killua365/fpgachina2026-sr-lut/skill/evidence/collaboration_record.md

# 本轮模型协作与纠错记录

日期：2026-10-20。模型角色：当前Codex编码助手；未调用子智能体或另一个模型。本文只记录本轮Skill任务，历史部分标为依据项目文件的复盘，不假冒原始对话导出。

## 用户需求的真实节选

> 参照赛题的要求，根据项目的具体情况，为我完成skill部分的内容，写清它在本队题目之外还能用在哪类场景

用户选择“文档＋脚本＋示例”，并要求确认这是PYNQ Skill。助手随后明确：

> PYNQ 是板端硬件运行的必需依赖；离线校验工具和教学示例可以在未安装 PYNQ 的普通电脑上独立运行。

用户最终要求：

> 按照方案执行，（严格参照赛题要求）

## 本轮执行记录

1. 读取3.3.2和3.3.5.2原条款，核对当前驱动和硬件验证脚本。发现原帧会话仍依赖SR专用寄存器，不宜直接作为通用模板。
2. 按P1/P2的合同及独立参考步骤设计两个场景：uint8阈值分割、int16采样饱和增益。黄金用标量整数运算，被测模拟用独立NumPy实现。
3. 编写实际PYNQ后端，通过显式Overlay加载、allocate与DMA transfer接入；算法控制交给hooks。离线入口不导入PYNQ。
4. 第一版模拟缓冲区使用 `obj.device` 保存设备侧数组。实际NumPy 2.x运行报错：

```text
AttributeError: attribute 'device' of 'numpy.ndarray' objects is not writable
```

5. 当时记录为23项、7个错误、0个断言失败；错误集中在模拟缓冲区构造。见 `initial_regression.json`，包含实际错误输出、环境与源码哈希。
6. 助手依据实际错误把自定义存储属性改为 `device_storage`，没有更改阈值、增益或判定标准。随后23项通过，两个外部场景运行及损坏数据检出均通过。后续新增检查和最终数量以 `regression.json`、`qualification.json` 为准。
7. 按P3/P4的方法复核r11 ARM记录及r5固定窗口记录，分别标记短测与历史持续验收；没有重启当前板端演示或伪造新板测试。

本文件是依据实际本轮操作编写的可追溯过程记录；提示词目录为提炼后的可复用版本，并不是声称上述模板文本曾在历史r5/r11阶段逐字输入。

## 结果与模型能力边界

工具结果证明具体脚本在记录环境中的行为。没有多模型、多次随机生成的成功率试验，不能宣称这些提示词对任意模型保证正确。使用者应执行相同的正例、反例和目标板验证。
