killua365/fpgachina2026-sr-lut/report/collaboration/index.md

# 大模型协作记录

工程开发使用大模型辅助分析、编码与验证。保留的记录覆盖通用 PYNQ Skill 的需求、方案、实际失败与修正，以及从 SR-LUT 项目提炼方法的过程。

| 资料 | 内容 |
|---|---|
| [真实需求与纠错记录](../../skill/evidence/collaboration_record.md) | 用户提示词节选、助手回答、NumPy 模拟缓冲区错误及修复 |
| [方法提炼过程](../../skill/evidence/derivation.md) | 从 DMA、缓存、像素校验及性能统计问题形成可复用流程 |
| [来源索引](../../skill/evidence/source_index.json) | 原始证据位置、内容哈希和 Skill 内对应文件 |
| [提示词工作流](../../skill/prompts/usage.md) | 经整理的可复用模板 |
| [机器可读索引](records.json) | 上述主要记录的 SHA-256 |

这些资料是现存任务记录和基于原始证据的整理，覆盖范围在各文件中说明。提示词模板不是历史逐字聊天记录；未据此补写不存在的对话或测试结果。
