killua365/fpgachina2026-sr-lut/skill/evidence/image_threshold/report.md

# PYNQ Skill 检查结果

- 通过：True
- 本轮硬件访问：否；不构成新板卡验收。

```json
{
  "schema": "pynq_skill_validation_v1",
  "date": "2026-10-20T19:09:30.595845+08:00",
  "hardware_access": false,
  "new_board_validation": false,
  "python": "3.12.14",
  "numpy": "2.2.6",
  "platform": "Windows-11-10.0.26200-SP0",
  "config_sha256": "9d28c4bf34c6cb34b576d8898f1ae898ba6bf69d05d6dc3a222fce5d29d514ce",
  "checks": {
    "golden": {
      "passed": true,
      "elements": 1536,
      "mismatches": 0,
      "maximum_absolute_error": 0.0,
      "atol": 0.0,
      "rtol": 0.0
    },
    "corruption_detected": {
      "passed": true
    }
  },
  "example": "image_threshold",
  "execution": "offline_simulated_dma",
  "measurement": {
    "host_total_seconds": 0.0,
    "hardware_access": false
  },
  "lifecycle_events": [
    "sync_to_device",
    "sync_to_device",
    "configure",
    "receive",
    "start",
    "send",
    "complete",
    "sync_from_device",
    "halt",
    "free",
    "free"
  ],
  "passed": true,
  "not_requested": [
    "files",
    "hwh",
    "throughput",
    "timing",
    "utilization"
  ]
}
```
