killua365/fpgachina2026-sr-lut/data/golden/fixed_x4_set5/bird_golden_1280x720.png

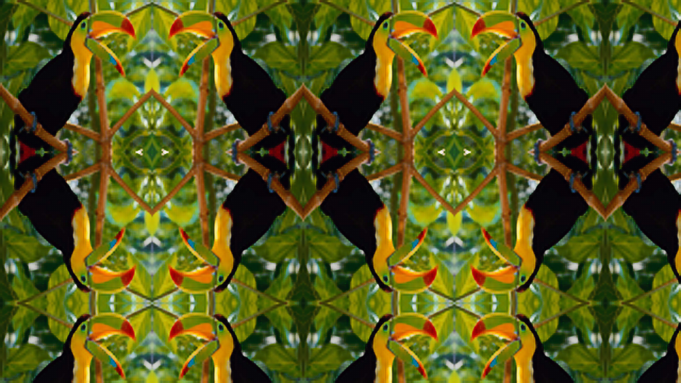
data/golden/fixed_x4_set5/bird_golden_1280x720.png
