killua365/fpgachina2026-sr-lut/data/golden/fixed_x4_set5/bird_input_320x180.png

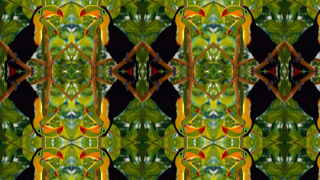
data/golden/fixed_x4_set5/bird_input_320x180.png
