killua365/fpgachina2026-sr-lut/data/golden/reference_baselines/x4_5bit/butterfly.png

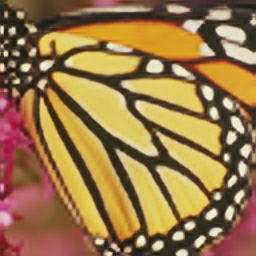
data/golden/reference_baselines/x4_5bit/butterfly.png
