killua365/fpgachina2026-sr-lut/data/golden/reference_baselines/x4_5bit/head.png

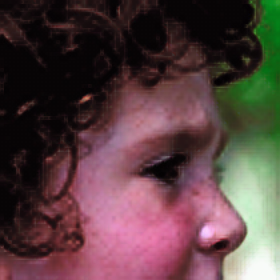
data/golden/reference_baselines/x4_5bit/head.png
