killua365/fpgachina2026-sr-lut/data/golden/reference_baselines/x4_5bit_boundaries/odd_gradient.png

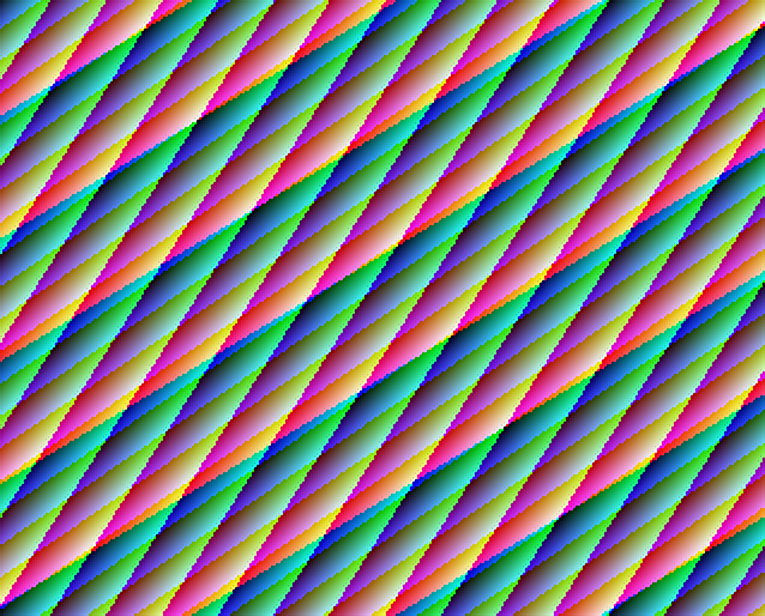
data/golden/reference_baselines/x4_5bit_boundaries/odd_gradient.png
