killua365/fpgachina2026-sr-lut/data/golden/smoke/golden_x2.png

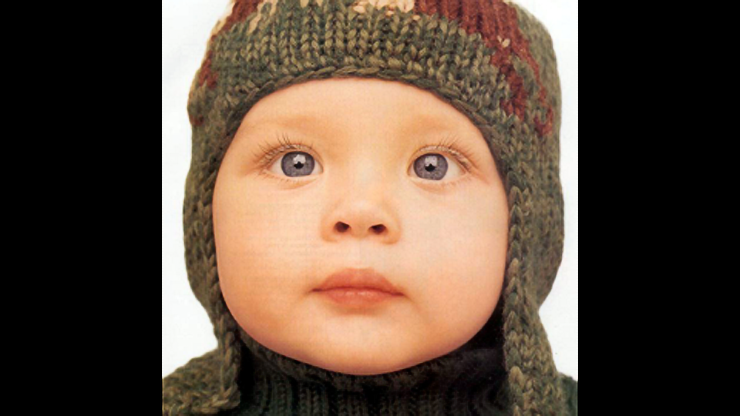
data/golden/smoke/golden_x2.png
