killua365/fpgachina2026-sr-lut/data/images/bird.png

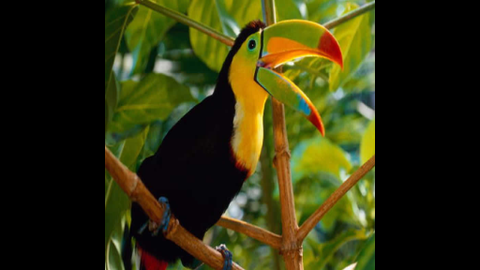
data/images/bird.png
