killua365/fpgachina2026-sr-lut/data/images/butterfly.png

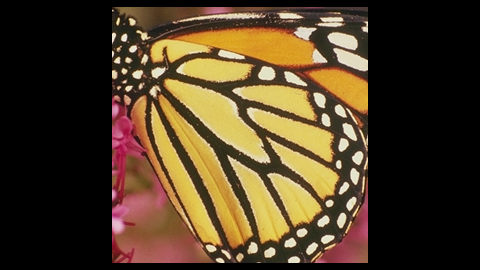
data/images/butterfly.png
