killua365/fpgachina2026-sr-lut/data/images/head.png

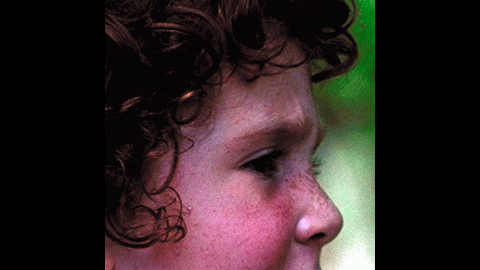
data/images/head.png
