killua365/fpgachina2026-sr-lut/data/images/woman.png

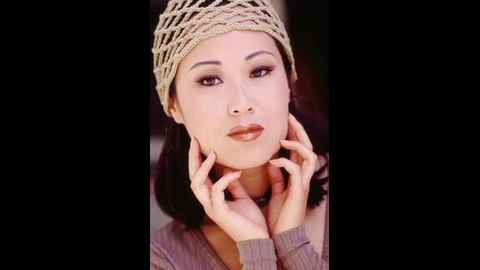
data/images/woman.png
