killua365/fpgachina2026-sr-lut/report/performance/camera_20fps_2026-10-18.md

# 摄像头完整新显示帧率测量

测量日期：2026-10-18。软件版本：`n5_business_20261018_r5`。会话：`228de59787e74140be1f62a6d9060c9b`。

| 布局 | Nexys 硬件计时窗口 | 完整新显示帧 | 实际帧率 |
|---|---:|---:|---:|
| SR 全屏 | 300 秒 | 6527 | 21.7567 fps |
| 原图/SR 分屏 | 300 秒 | 6727 | 22.4233 fps |

帧率由 Nexys 完整扫描事件独立重算，排除重复显示；不使用摄像头采集率、PYNQ 提交率或显示器刷新率代替。该结果属于历史 DP 配置，不能直接作为当前 VGA 配置的成绩。

## 条件与实现

摄像头为 640×480 MJPEG，保持面积缩放与宽高比；SR 输入 480×270，x4 输出 1920×1080，HDMI 1080p30，DP 1080p60。LUT、BIT/HWH 和黄金参考数据未因优化而改变。

优化将完整像素校验与复制合并，使用非缓存显示缓冲区，减少重复缓存刷新；全屏复用不透明工具栏，只更新可见图像区域与发生变化的界面元素。鼠标、提示文字、布局或图像代次变化时重新绘制。

x2/x4 黄金输出、30 帧摄像头 SR 结果和 30 帧完整 RGBX 显示画面通过核对，覆盖全屏、分屏和三个轮换缓冲区。SR 输出 X 字节检查包含被工具栏遮住的像素。

## 证据复算

在工程根目录运行：

```powershell
.\tools\python.cmd host tools/recompute_camera.py --out D:\sr_lut_r5_recomputed
```

输出目录须为新目录。工具校验并读取[原始证据包](camera_r5_evidence.zip)，使用包内当时的复算代码，不依赖旧工作目录或当前板卡。普通运行入口与操作见[操作手册](../../docs/user_guide.md)。

相关来源：[r6 来源合同](r6_source_contract.json)、[历史软件验证](../validation/historical_validation.zip)。r6 普通演示包保留 r5 的 124 个载荷文件，仅关闭自动测速并记录来源。

ARM 63 项测试全部通过；主机 155 项中 5 项仅适用于 ARM。标准输入启动曾造成四项多进程测试失败，改用模块入口后对应 10 项通过；启动计时测试曾超阈值约 0.16 秒，完整复测 125 项通过。原始失败与复测记录一并保留。

此结果覆盖表中两项性能，不证明全部模式、插拔可靠性或无主机启动。会话结束记录确认源程序停止、服务与 Nexys 配置恢复；遥测记录与显示器实屏观察分别保存。
