killua365/fpgachina2026-sr-lut/skill/evidence/validation_summary.md

# 本轮验证结果

日期：2026-10-20。所有本轮检查均未访问开发板，未停止或重启当前演示。

| 环境 | 回归 | 独立目录 | 独立示例 | 原报告检查 |
|---|---|---|---|---|
| Python 3.12.14 / NumPy 2.2.6 | 28项通过 | 主项目目录 | 两例通过 | 通过 |
| Python 3.12.14 / NumPy 2.5.4 | 28项通过 | 新venv＋临时独立副本 | 两例通过 | 通过 |
| Python 3.12.14 / NumPy 1.26.4 | 28项通过 | 临时独立副本 | 两例通过 | 通过 |

- 新venv按requirements.txt实际安装依赖；不是只使用原项目已安装的库。
- 图像例子1536个元素，传感器例子36个元素，整数逐元素一致；故意破坏结果均被检出。
- 原x4工程报告：setup WNS 0.144 ns，hold 0.014 ns，pulse 0.538 ns；LUT 19220、FF 18035、RAMB36 111、RAMB18 4、DSP 2。这是历史原报告重读，不是本轮重新综合。
- 第一次23项测试出现7个错误，原因是NumPy 2.x已有device属性；修正并增加边界检查后最终每环境28项通过。失败记录保留。
- 新模板未上板；Python 3.10仅检查语法，未在3.10解释器运行。PYNQ 3.1.1为原项目环境，不冒充新模板实板验证。

原始机器记录见qualification.json及各环境子目录。
