killua365/fpgachina2026-sr-lut/skill/templates/experiment_report.md

# 可复用实验报告模板

- 题目/算法/日期：
- 板卡与器件、PYNQ/Python/NumPy/Vivado版本：
- 源码版本、BIT/HWH与配置的SHA-256：
- 实验层级：离线参考 / 模拟设备 / 真板；是否访问硬件：
- 输入输出规格、同一对比条件：
- 黄金方法、误差口径、边界及故意损坏检出：
- 性能计时起止点、窗口、有效批次数、重复排除、P50/P95/最大延迟：
- 实现后的setup/hold/pulse时序与约束覆盖边界：
- LUT/FF/RAMB36/RAMB18/DSP；预算和实际用途：
- 原始证据路径：
- 失败观察、候选原因、修复与复核：
- 可复用到哪些外部题目、需要修改哪些参数：
- 未验证范围与失效条件：

不能将离线运行或瞬时峰值填入“真板持续性能”；跳过的检查明确写“未执行”。
