killua365/fpgachina2026-sr-lut/report/validation/reorganization_20261020/tests.txt

test_broken_or_nonascii_property_rejected (test_device_status.DeviceStatusTests.test_broken_or_nonascii_property_rejected) ... ok
test_locale_paths_and_line_endings (test_device_status.DeviceStatusTests.test_locale_paths_and_line_endings) ... ok
test_missing_duplicate_and_wrong_identity_rejected (test_device_status.DeviceStatusTests.test_missing_duplicate_and_wrong_identity_rejected) ... ok
test_fragmented_binary_and_chunk_boundaries_are_exact (test_ftdi_capture.CaptureTests.test_fragmented_binary_and_chunk_boundaries_are_exact) ... ok
test_line_error_and_clear_times_preserved_with_all_received_bytes (test_ftdi_capture.CaptureTests.test_line_error_and_clear_times_preserved_with_all_received_bytes) ... ok
test_restoration_failure_and_independent_deadline_fail (test_ftdi_capture.CaptureTests.test_restoration_failure_and_independent_deadline_fail) ... ok
test_new_errors_missing_tail_and_regression_are_rejected (test_ftdi_status.StatusTests.test_new_errors_missing_tail_and_regression_are_rejected) ... ok
test_preexisting_error_must_clear_before_candidate (test_ftdi_status.StatusTests.test_preexisting_error_must_clear_before_candidate) ... ok
test_business_only_limits_fit_independent_hold (test_business_session.SessionTests.test_business_only_limits_fit_independent_hold) ... ok
test_close_requires_dma_worker_and_live_original_service (test_business_session.SessionTests.test_close_requires_dma_worker_and_live_original_service) ... ok
test_complete_raw_stream_and_source_join (test_business_session.SessionTests.test_complete_raw_stream_and_source_join) ... ok
test_current_binding_required_before_final_report (test_business_session.SessionTests.test_current_binding_required_before_final_report) ... ok
test_finalizing_needs_live_binding_and_closed_hardware (test_business_session.SessionTests.test_finalizing_needs_live_binding_and_closed_hardware) ... ok
test_fresh_baseline_is_run_bound (test_business_session.SessionTests.test_fresh_baseline_is_run_bound) ... ok
test_journal_loss_mutation_and_source_replay_fail (test_business_session.SessionTests.test_journal_loss_mutation_and_source_replay_fail) ... ok
test_launch_rejects_old_package_duration_and_foreign_directory (test_business_session.SessionTests.test_launch_rejects_old_package_duration_and_foreign_directory) ... ok
test_probe_uses_closed_worker_report_while_parent_restores (test_business_session.SessionTests.test_probe_uses_closed_worker_report_while_parent_restores) ... ok
test_recent_resynchronization_still_rejects_new_damage_and_sequence_gaps (test_business_session.SessionTests.test_recent_resynchronization_still_rejects_new_damage_and_sequence_gaps) ... ok
test_recent_srb5_rejects_wrong_identity_crc_and_gaps (test_business_session.SessionTests.test_recent_srb5_rejects_wrong_identity_crc_and_gaps) ... ok
test_recent_status_recovers_alignment_without_accepting_corrupt_session (test_business_session.SessionTests.test_recent_status_recovers_alignment_without_accepting_corrupt_session) ... ok
test_source_start_requires_current_live_nexys_session (test_business_session.SessionTests.test_source_start_requires_current_live_nexys_session) ... ok
test_close_keeps_candidate_until_ordered_restore (test_business_session_loader.LoaderTests.test_close_keeps_candidate_until_ordered_restore) ... ok
test_failed_recovery_stays_unknown (test_business_session_loader.LoaderTests.test_failed_recovery_stays_unknown) ... ok
test_operator_loader_keeps_ordering_lease_and_independent_cap (test_business_session_loader.LoaderTests.test_operator_loader_keeps_ordering_lease_and_independent_cap) ... ok
test_preload_failures_never_program (test_business_session_loader.LoaderTests.test_preload_failures_never_program) ... ok
test_watchdogs_and_bad_commands_restore_but_fail (test_business_session_loader.LoaderTests.test_watchdogs_and_bad_commands_restore_but_fail) ... ok
test_boundary_loss_and_hung_loader_are_bounded (test_business_session_supervisor.ControllerTests.test_boundary_loss_and_hung_loader_are_bounded) ... ok
test_closed_worker_waits_for_parent_restore_without_false_failure (test_business_session_supervisor.ControllerTests.test_closed_worker_waits_for_parent_restore_without_false_failure) ... ok
test_finalizing_without_parent_completion_still_times_out (test_business_session_supervisor.ControllerTests.test_finalizing_without_parent_completion_still_times_out) ... ok
test_manual_session_runs_beyond_old_caps_then_closes_before_stop_and_restore (test_business_session_supervisor.ControllerTests.test_manual_session_runs_beyond_old_caps_then_closes_before_stop_and_restore) ... ok
test_manual_source_safety_failure_restores_without_passing (test_business_session_supervisor.ControllerTests.test_manual_source_safety_failure_restores_without_passing) ... ok
test_natural_source_completion_closes_then_recovers_without_prompt (test_business_session_supervisor.ControllerTests.test_natural_source_completion_closes_then_recovers_without_prompt) ... ok
test_operator_finish_preserves_order_and_does_not_send_sudo (test_business_session_supervisor.ControllerTests.test_operator_finish_preserves_order_and_does_not_send_sudo) ... ok
test_raw_factory_tail_is_not_parsed_as_candidate (test_business_session_supervisor.ControllerTests.test_raw_factory_tail_is_not_parsed_as_candidate) ... ok
test_transport_and_cancel_faults_never_pass (test_business_session_supervisor.ControllerTests.test_transport_and_cancel_faults_never_pass) ... ok
test_worker_deadline_and_recovery_failure_remain_failures (test_business_session_supervisor.ControllerTests.test_worker_deadline_and_recovery_failure_remain_failures) ... ok
test_launch_rejects_foreign_path_and_unbounded_profiles_before_hardware (test_hdmi_session_trace.TraceTests.test_launch_rejects_foreign_path_and_unbounded_profiles_before_hardware) ... ok
test_repaint_mode_generation_and_regression (test_hdmi_session_trace.TraceTests.test_repaint_mode_generation_and_regression) ... ok
test_failed_submit_and_failed_trace_cannot_fake_success (test_hdmi_session_trace.ObserverTests.test_failed_submit_and_failed_trace_cannot_fake_success) ... ok
test_observer_follows_submission_and_rejects_stale_pair (test_hdmi_session_trace.ObserverTests.test_observer_follows_submission_and_rejects_stale_pair) ... ok
test_halt_failure_prevents_overlay_replacement (test_hdmi_engine.EngineTests.test_halt_failure_prevents_overlay_replacement) ... ok
test_mode_change_rejects_old_pair_and_geometry_change_closes_session (test_hdmi_engine.EngineTests.test_mode_change_rejects_old_pair_and_geometry_change_closes_session) ... ok
test_modes_reuse_same_scale_and_camera_stays_x4 (test_hdmi_engine.EngineTests.test_modes_reuse_same_scale_and_camera_stays_x4) ... ok
test_roi_uses_original_pixels_and_exact_halo_crop (test_hdmi_engine.EngineTests.test_roi_uses_original_pixels_and_exact_halo_crop) ... ok
test_camera_fixed_scale_and_idle_stop_preserve_display (test_hdmi_runtime.RuntimeTests.test_camera_fixed_scale_and_idle_stop_preserve_display) ... ok
test_camera_recovery_invalidates_old_frame_generation (test_hdmi_runtime.RuntimeTests.test_camera_recovery_invalidates_old_frame_generation) ... ok
test_idle_repaints_surface_and_cannot_count_as_processing (test_hdmi_runtime.RuntimeTests.test_idle_repaints_surface_and_cannot_count_as_processing) ... ok
test_image_repaint_does_not_reprocess_or_count_a_new_source_frame (test_hdmi_runtime.RuntimeTests.test_image_repaint_does_not_reprocess_or_count_a_new_source_frame) ... ok
test_roi_change_rejects_previous_generation_and_uses_original_pixels (test_hdmi_runtime.RuntimeTests.test_roi_change_rejects_previous_generation_and_uses_original_pixels) ... ok
test_status_separates_processing_and_new_frame_rates (test_hdmi_runtime.RuntimeTests.test_status_separates_processing_and_new_frame_rates) ... ok
test_video_seek_and_exact_step_bind_matching_frame_pairs (test_hdmi_runtime.RuntimeTests.test_video_seek_and_exact_step_bind_matching_frame_pairs) ... ok
test_inventory_and_all_python_modules_are_bound (test_business_package_binding.PackageBindingTests.test_inventory_and_all_python_modules_are_bound) ... ok
test_previous_launches_cannot_start_current_session (test_business_package_binding.PackageBindingTests.test_previous_launches_cannot_start_current_session) ... ok
test_inventory_and_verification_stream_large_files_and_reject_changes (test_business_evidence_files.EvidenceFilesTests.test_inventory_and_verification_stream_large_files_and_reject_changes) ... ok
test_transfer_budget_remains_bounded_for_retained_video (test_business_evidence_files.EvidenceFilesTests.test_transfer_budget_remains_bounded_for_retained_video) ... ok
test_foreign_dropin_is_preserved (test_bootpy_once.BootOnceTests.test_foreign_dropin_is_preserved) ... ok
test_install_is_idempotent_and_rollback_removes_only_own_file (test_bootpy_once.BootOnceTests.test_install_is_idempotent_and_rollback_removes_only_own_file) ... ok
test_installer_does_not_start_services_or_reboot (test_bootpy_once.BootOnceTests.test_installer_does_not_start_services_or_reboot) ... ok
test_installer_reverts_file_when_reload_fails (test_bootpy_once.BootOnceTests.test_installer_reverts_file_when_reload_fails) ... ok
test_old_busy_failed_and_incomplete_states_are_rejected (test_bootpy_once.BootOnceTests.test_old_busy_failed_and_incomplete_states_are_rejected) ... ok
test_recovery_never_starts_service_with_uncompleted_boot (test_bootpy_once.BootOnceTests.test_recovery_never_starts_service_with_uncompleted_boot) ... ok
test_successful_exited_initialization_is_not_a_live_owner (test_bootpy_once.BootOnceTests.test_successful_exited_initialization_is_not_a_live_owner) ... ok
test_unexpected_boot_rerun_is_not_success (test_bootpy_once.BootOnceTests.test_unexpected_boot_rerun_is_not_success) ... ok
test_active_candidate_prevents_start (test_business_recovery_status.RecoveryStatusTests.test_active_candidate_prevents_start) ... ok
test_start_timeout_remains_failure (test_business_recovery_status.RecoveryStatusTests.test_start_timeout_remains_failure) ... ok
test_success_records_identity_before_completion (test_business_recovery_status.RecoveryStatusTests.test_success_records_identity_before_completion) ... ok
test_wrong_identity_remains_failure (test_business_recovery_status.RecoveryStatusTests.test_wrong_identity_remains_failure) ... ok
test_persistent_adapter_still_rejects_stale_challenge (test_business_query.PersistentQueryTests.test_persistent_adapter_still_rejects_stale_challenge) ... ok
test_persistent_timeout_does_not_return_a_previous_response (test_business_query.PersistentQueryTests.test_persistent_timeout_does_not_return_a_previous_response) ... ok
test_read_only_server_reuses_process_with_fresh_replies (test_business_query.PersistentQueryTests.test_read_only_server_reuses_process_with_fresh_replies) ... ok
test_controller_failure_closure_or_finalizing_blocks_interaction (test_business_query.ProgressTests.test_controller_failure_closure_or_finalizing_blocks_interaction) ... ok
test_banner_after_five_seconds_reaches_key_exchange (test_business_query.QueryDeadlineTests.test_banner_after_five_seconds_reaches_key_exchange) ... ok
test_silent_peer_still_expires_within_total_budget (test_business_query.QueryDeadlineTests.test_silent_peer_still_expires_within_total_budget) ... ok
test_success_retains_binding_and_timing (test_business_query.QueryTests.test_success_retains_binding_and_timing) ... ok
test_successful_ssh_with_stale_response_is_still_rejected (test_business_query.QueryTests.test_successful_ssh_with_stale_response_is_still_rejected) ... ok
test_timeout_keeps_partial_stages_without_retry_or_binding (test_business_query.QueryTests.test_timeout_keeps_partial_stages_without_retry_or_binding) ... ok
test_transport_failure_preserves_useful_error_without_command (test_business_query.QueryTests.test_transport_failure_preserves_useful_error_without_command) ... ok
test_completed_file_is_preserved_and_final_success_replaces_stale_sample (test_business_final_media.FinalMediaTests.test_completed_file_is_preserved_and_final_success_replaces_stale_sample) ... ok
test_failed_hardware_close_does_not_claim_finalization (test_business_final_media.FinalMediaTests.test_failed_hardware_close_does_not_claim_finalization) ... ok
test_shutdown_during_probe_records_cancel_and_removes_partial (test_business_final_media.FinalMediaTests.test_shutdown_during_probe_records_cancel_and_removes_partial) ... ok
test_cli_propagates_manual_mode_and_rejects_short_cap (test_business_operator.OperatorTests.test_cli_propagates_manual_mode_and_rejects_short_cap) ... ok
test_default_launch_is_demo_but_explicit_seconds_retains_timed (test_business_operator.OperatorTests.test_default_launch_is_demo_but_explicit_seconds_retains_timed) ... ok
test_mode_bound_to_launch_process_worker_and_supervisor (test_business_operator.OperatorTests.test_mode_bound_to_launch_process_worker_and_supervisor) ... ok
test_operator_controller_outlives_old_window_and_preserves_stop_order (test_business_operator.OperatorTests.test_operator_controller_outlives_old_window_and_preserves_stop_order) ... ok
test_operator_faults_and_safety_caps_remain_enforced (test_business_operator.OperatorTests.test_operator_faults_and_safety_caps_remain_enforced) ... ok
test_operator_outlives_five_minutes_and_ends_on_operator (test_business_operator.OperatorTests.test_operator_outlives_five_minutes_and_ends_on_operator) ... ok
test_safety_cap_recovers_as_failure_not_success (test_business_operator.OperatorTests.test_safety_cap_recovers_as_failure_not_success) ... ok
test_camera_cached_overlay_matches_drawing_and_preserves_background (test_hdmi_workspace.WorkspaceTests.test_camera_cached_overlay_matches_drawing_and_preserves_background) ... ok
test_camera_content_band_only_excludes_fully_opaque_rows (test_hdmi_workspace.WorkspaceTests.test_camera_content_band_only_excludes_fully_opaque_rows) ... ok
test_cursor_motion_repaints_static_image_without_processing (test_hdmi_workspace.WorkspaceTests.test_cursor_motion_repaints_static_image_without_processing) ... ok
test_disconnect_cancels_drag_instead_of_committing_a_phantom_roi (test_hdmi_workspace.WorkspaceTests.test_disconnect_cancels_drag_instead_of_committing_a_phantom_roi) ... ok
test_export_decodes_exact_pixels_and_no_reference_quality_is_invented (test_hdmi_workspace.WorkspaceTests.test_export_decodes_exact_pixels_and_no_reference_quality_is_invented) ... ok
test_manual_session_has_no_short_countdown (test_hdmi_workspace.WorkspaceTests.test_manual_session_has_no_short_countdown) ... ok
test_moving_cursor_reuses_static_overlay_but_invalidates_slot_key (test_hdmi_workspace.WorkspaceTests.test_moving_cursor_reuses_static_overlay_but_invalidates_slot_key) ... ok
test_partial_camera_band_restores_pointer_over_content (test_hdmi_workspace.WorkspaceTests.test_partial_camera_band_restores_pointer_over_content) ... ok
test_roi_move_commits_original_coordinates_only_on_release (test_hdmi_workspace.WorkspaceTests.test_roi_move_commits_original_coordinates_only_on_release) ... ok
test_save_failure_has_visible_error_without_false_success (test_hdmi_workspace.WorkspaceTests.test_save_failure_has_visible_error_without_false_success) ... ok
test_save_feedback_remains_visible_when_toolbar_hides_and_is_reported (test_hdmi_workspace.WorkspaceTests.test_save_feedback_remains_visible_when_toolbar_hides_and_is_reported) ... ok
test_selection_background_cached_and_invalidated_on_new_image (test_hdmi_workspace.WorkspaceTests.test_selection_background_cached_and_invalidated_on_new_image) ... ok
test_selection_cached_pixels_match_reference_with_notice_and_roi_changes (test_hdmi_workspace.WorkspaceTests.test_selection_cached_pixels_match_reference_with_notice_and_roi_changes) ... ok
test_selection_repaint_skips_hidden_sr_composition (test_hdmi_workspace.WorkspaceTests.test_selection_repaint_skips_hidden_sr_composition) ... ok
test_session_countdown_does_not_depend_on_toolbar_visibility (test_hdmi_workspace.WorkspaceTests.test_session_countdown_does_not_depend_on_toolbar_visibility) ... ok
test_short_click_changes_layout_without_changing_physical_mode_or_scale (test_hdmi_workspace.WorkspaceTests.test_short_click_changes_layout_without_changing_physical_mode_or_scale) ... ok
test_single_pixel_roi_displays_and_exports_on_board_opencv (test_hdmi_workspace.WorkspaceTests.test_single_pixel_roi_displays_and_exports_on_board_opencv) ... ok
test_invalid_wipe_rejected (test_hdmi_display.CompositionTests.test_invalid_wipe_rejected) ... ok
test_pixel_pan_keeps_views_aligned (test_hdmi_display.CompositionTests.test_pixel_pan_keeps_views_aligned) ... ok
test_sources_are_not_modified (test_hdmi_display.CompositionTests.test_sources_are_not_modified) ... ok
test_split_has_same_geometry_and_no_color_swap (test_hdmi_display.CompositionTests.test_split_has_same_geometry_and_no_color_swap) ... ok
test_virtual_baseline_crop_matches_expanded_pixels_at_all_scale_phases (test_hdmi_display.CompositionTests.test_virtual_baseline_crop_matches_expanded_pixels_at_all_scale_phases) ... ok
test_wipe_preserves_corresponding_pixels (test_hdmi_display.CompositionTests.test_wipe_preserves_corresponding_pixels) ... ok
test_fabricated_sequence_and_wrong_geometry_rejected (test_hdmi_display.FrameTests.test_fabricated_sequence_and_wrong_geometry_rejected) ... ok
test_outdated_and_duplicate_frames_do_not_publish (test_hdmi_display.FrameTests.test_outdated_and_duplicate_frames_do_not_publish) ... ok
test_full_image_display_rect_and_bad_dimension (test_hdmi_display.GeometryTests.test_full_image_display_rect_and_bad_dimension) ... ok
test_letterbox_maps_to_original_not_thumbnail (test_hdmi_display.GeometryTests.test_letterbox_maps_to_original_not_thumbnail) ... ok
test_padding_click_and_hardware_limit_rejected (test_hdmi_display.GeometryTests.test_padding_click_and_hardware_limit_rejected) ... ok
test_single_pixel_roi_and_reverse_drag (test_hdmi_display.GeometryTests.test_single_pixel_roi_and_reverse_drag) ... ok
test_camera_restart_drops_pending_old_generation (test_hdmi_camera_pipeline.CameraPipelineTests.test_camera_restart_drops_pending_old_generation) ... ok
test_idle_and_scale_transition_discard_pending_and_close_borrowed_storage (test_hdmi_camera_pipeline.CameraPipelineTests.test_idle_and_scale_transition_discard_pending_and_close_borrowed_storage) ... ok
test_overlap_preserves_matching_source_and_output_and_expires_old_slot (test_hdmi_camera_pipeline.CameraPipelineTests.test_overlap_preserves_matching_source_and_output_and_expires_old_slot) ... ok
test_bad_length_and_wrong_channel_are_rejected (test_hdmi_acp_receive.AcpCompletionTests.test_bad_length_and_wrong_channel_are_rejected) ... ok
test_coherent_completion_requires_matching_bit_and_hwh (test_hdmi_acp_receive.AcpCompletionTests.test_coherent_completion_requires_matching_bit_and_hwh) ... ok
test_completes_same_buffer_without_software_invalidate (test_hdmi_acp_receive.AcpCompletionTests.test_completes_same_buffer_without_software_invalidate) ... ok
test_errors_preserve_buffer_for_owned_recovery (test_hdmi_acp_receive.AcpCompletionTests.test_errors_preserve_buffer_for_owned_recovery) ... ok
test_timeout_keeps_ownership (test_hdmi_acp_receive.AcpCompletionTests.test_timeout_keeps_ownership) ... ok
test_unknown_driver_uses_existing_completion (test_hdmi_acp_receive.AcpCompletionTests.test_unknown_driver_uses_existing_completion) ... ok
test_cancel_releases_ready_reservation_without_freeing_scanout (test_hdmi_camera_optimized.DirectCameraTests.test_cancel_releases_ready_reservation_without_freeing_scanout) ... ok
test_checked_copy_matches_compositor_and_rejects_discarded_pixel_corruption (test_hdmi_camera_optimized.DirectCameraTests.test_checked_copy_matches_compositor_and_rejects_discarded_pixel_corruption) ... ok
test_corrupt_last_x_byte_never_reaches_vdma (test_hdmi_camera_optimized.DirectCameraTests.test_corrupt_last_x_byte_never_reaches_vdma) ... ok
test_rotation_overlap_and_repaint_regenerate_clean_sr (test_hdmi_camera_optimized.DirectCameraTests.test_rotation_overlap_and_repaint_regenerate_clean_sr) ... ok
test_split_partial_repaint_matches_full_and_invalidates_for_pointer_change (test_hdmi_camera_optimized.DirectCameraTests.test_split_partial_repaint_matches_full_and_invalidates_for_pointer_change) ... ok
test_1080p_timing_uses_cea_progressive_porches_for_both_rates (test_hdmi_scanout.ScanoutTests.test_1080p_timing_uses_cea_progressive_porches_for_both_rates) ... ok
test_720p_timing_reconstructs_standard_clock_and_sync (test_hdmi_scanout.ScanoutTests.test_720p_timing_reconstructs_standard_clock_and_sync) ... ok
test_cache_flush_precedes_submit_and_duplicate_lease_is_rejected (test_hdmi_scanout.ScanoutTests.test_cache_flush_precedes_submit_and_duplicate_lease_is_rejected) ... ok
test_direct_camera_reservations_do_not_alias_active_pending_or_ready (test_hdmi_scanout.ScanoutTests.test_direct_camera_reservations_do_not_alias_active_pending_or_ready) ... ok
test_dma_errors_are_not_silently_cleared (test_hdmi_scanout.ScanoutTests.test_dma_errors_are_not_silently_cleared) ... ok
test_failed_stop_retains_memory_until_later_confirmed_halt (test_hdmi_scanout.ScanoutTests.test_failed_stop_retains_memory_until_later_confirmed_halt) ... ok
test_overlay_factory_uses_mmio_without_binding_interrupt_driver (test_hdmi_scanout.ScanoutTests.test_overlay_factory_uses_mmio_without_binding_interrupt_driver) ... ok
test_ranged_sync_uses_exact_rows_and_rejects_out_of_bounds (test_hdmi_scanout.ScanoutTests.test_ranged_sync_uses_exact_rows_and_rejects_out_of_bounds) ... ok
test_running_dma_is_not_stolen (test_hdmi_scanout.ScanoutTests.test_running_dma_is_not_stolen) ... ok
test_source_counts_require_hardware_ack_and_exclude_ui_and_repeat_pairs (test_hdmi_scanout.ScanoutTests.test_source_counts_require_hardware_ack_and_exclude_ui_and_repeat_pairs) ... ok
test_three_buffers_do_not_recycle_scanning_or_pending (test_hdmi_scanout.ScanoutTests.test_three_buffers_do_not_recycle_scanning_or_pending) ... ok
test_exact_pixels_strides_guards_and_all_discarded_positions (test_hdmi_checked_copy.CheckedCopyTests.test_exact_pixels_strides_guards_and_all_discarded_positions) ... ok
test_invalid_geometry_and_aliasing (test_hdmi_checked_copy.CheckedCopyTests.test_invalid_geometry_and_aliasing) ... ok
test_default_format_preserves_negotiated_full_resolution_and_rate (test_hdmi_camera.CameraTests.test_default_format_preserves_negotiated_full_resolution_and_rate) ... ok
test_20fps_fixed_window_counts_exactly_6000 (test_camera_performance.CameraAcceptanceTests.test_20fps_fixed_window_counts_exactly_6000) ... ok
test_checked_copy_requires_both_layouts_and_exact_scanout (test_camera_performance.CameraAcceptanceTests.test_checked_copy_requires_both_layouts_and_exact_scanout) ... ok
test_diagnostic_only_cannot_be_promoted (test_camera_performance.CameraAcceptanceTests.test_diagnostic_only_cannot_be_promoted) ... ok
test_direct_scanout_requires_all_three_slots_with_exact_pixels (test_camera_performance.CameraAcceptanceTests.test_direct_scanout_requires_all_three_slots_with_exact_pixels) ... ok
test_fast_submissions_cannot_hide_slow_display (test_camera_performance.CameraAcceptanceTests.test_fast_submissions_cannot_hide_slow_display) ... ok
test_short_window_replays_and_reduced_geometry_fail (test_camera_performance.CameraAcceptanceTests.test_short_window_replays_and_reduced_geometry_fail) ... ok
test_request_is_explicit_run_bound_and_one_shot (test_hdmi_presentation.CampaignRequestTests.test_request_is_explicit_run_bound_and_one_shot) ... ok
test_camera_restart_while_frozen_keeps_owned_snapshot (test_hdmi_presentation.FreezeTests.test_camera_restart_while_frozen_keeps_owned_snapshot) ... ok
test_invalid_borrowed_frame_or_hidden_corruption_cannot_freeze (test_hdmi_presentation.FreezeTests.test_invalid_borrowed_frame_or_hidden_corruption_cannot_freeze) ... ok
test_mode_change_releases_freeze_and_resets_view (test_hdmi_presentation.FreezeTests.test_mode_change_releases_freeze_and_resets_view) ... ok
test_no_frame_does_not_freeze (test_hdmi_presentation.FreezeTests.test_no_frame_does_not_freeze) ... ok
test_resume_discards_old_capture_and_restarts_identity (test_hdmi_presentation.FreezeTests.test_resume_discards_old_capture_and_restarts_identity) ... ok
test_saving_blocks_resume_and_duplicate_but_can_cancel (test_hdmi_presentation.FreezeTests.test_saving_blocks_resume_and_duplicate_but_can_cancel) ... ok
test_snapshot_exports_exact_same_frame_with_comparison (test_hdmi_presentation.FreezeTests.test_snapshot_exports_exact_same_frame_with_comparison) ... ok
test_snapshot_owns_last_displayed_pair_and_does_not_count_repaints (test_hdmi_presentation.FreezeTests.test_snapshot_owns_last_displayed_pair_and_does_not_count_repaints) ... ok
test_dropped_event_cancels_drag_without_a_stale_release_commit (test_hdmi_presentation.ViewInteractionTests.test_dropped_event_cancels_drag_without_a_stale_release_commit) ... ok
test_dynamic_pan_and_wipe_do_not_rebuild_static_camera_overlay (test_hdmi_presentation.ViewInteractionTests.test_dynamic_pan_and_wipe_do_not_rebuild_static_camera_overlay) ... ok
test_view_label_highlight_and_reset_do_not_change_roi (test_hdmi_presentation.ViewInteractionTests.test_view_label_highlight_and_reset_do_not_change_roi) ... ok
test_wipe_caps_and_handle_stay_inside_picture_and_above_toolbar (test_hdmi_presentation.ViewInteractionTests.test_wipe_caps_and_handle_stay_inside_picture_and_above_toolbar) ... ok
test_wipe_drag_uses_content_bounds_and_release_coordinate (test_hdmi_presentation.ViewInteractionTests.test_wipe_drag_uses_content_bounds_and_release_coordinate) ... ok
test_wipe_line_reaches_visible_picture_bottom_in_all_modes (test_hdmi_presentation.ViewInteractionTests.test_wipe_line_reaches_visible_picture_bottom_in_all_modes) ... ok
test_cached_wipe_matches_independent_reference_all_pan_phases (test_hdmi_presentation.WipeTests.test_cached_wipe_matches_independent_reference_all_pan_phases) ... ok
test_cancelled_export_leaves_no_completed_or_partial_directory (test_hdmi_presentation.WipeTests.test_cancelled_export_leaves_no_completed_or_partial_directory) ... ok
test_fused_wipe_cuts_padding_and_hidden_x_validation (test_hdmi_presentation.WipeTests.test_fused_wipe_cuts_padding_and_hidden_x_validation) ... ok
test_wipe_input_validation (test_hdmi_presentation.WipeTests.test_wipe_input_validation) ... ok
test_external_display_allocations_are_not_freed_by_sr_session (test_video_pipeline.VideoPipelineTests.test_external_display_allocations_are_not_freed_by_sr_session) ... ok
test_overlap_executes_after_dma_launch_before_wait_and_recovers_on_error (test_video_pipeline.VideoPipelineTests.test_overlap_executes_after_dma_launch_before_wait_and_recovers_on_error) ... ok
test_all_real_pairs_and_roi_match_scale_specific_hr (test_hdmi_metrics.MetricTests.test_all_real_pairs_and_roi_match_scale_specific_hr) ... ok
test_atomic_switch_loads_new_lr_before_processing (test_hdmi_metrics.MetricTests.test_atomic_switch_loads_new_lr_before_processing) ... ok
test_fps_window_repaints_freeze_disconnect_and_generation (test_hdmi_metrics.MetricTests.test_fps_window_repaints_freeze_disconnect_and_generation) ... ok
test_quality_worker_drops_old_result (test_hdmi_metrics.MetricTests.test_quality_worker_drops_old_result) ... ok
test_small_cached_header_changes_with_dimensions_and_signed_delta (test_hdmi_metrics.MetricTests.test_small_cached_header_changes_with_dimensions_and_signed_delta) ... ok
test_explicit_test_modes_keep_golden_checks (test_business_demo.DemoTests.test_explicit_test_modes_keep_golden_checks) ... ok
test_log_rotation_bounds_all_retained_files (test_business_demo.DemoTests.test_log_rotation_bounds_all_retained_files) ... ok
test_normal_demo_skips_all_golden_work_and_writes_no_test_files (test_business_demo.DemoTests.test_normal_demo_skips_all_golden_work_and_writes_no_test_files) ... ok
test_uart_demo_has_no_old_capture_deadline (test_business_demo.DemoTests.test_uart_demo_has_no_old_capture_deadline) ... ok
test_unlimited_budget_and_controller_cross_all_old_limits (test_business_demo.DemoTests.test_unlimited_budget_and_controller_cross_all_old_limits) ... ok
test_unlimited_retains_start_and_stop_timeouts (test_business_demo.DemoTests.test_unlimited_retains_start_and_stop_timeouts) ... ok
test_actual_frame_edges_anchor_normal_and_narrow_image_captions (test_hdmi_compare_layout.CompareLayoutTests.test_actual_frame_edges_anchor_normal_and_narrow_image_captions) ... ok
test_all_shapes_keep_captions_and_fps_outside_pictures_and_toolbar (test_hdmi_compare_layout.CompareLayoutTests.test_all_shapes_keep_captions_and_fps_outside_pictures_and_toolbar) ... ok
test_camera_fit_retains_exact_native_fast_path_band (test_hdmi_compare_layout.CompareLayoutTests.test_camera_fit_retains_exact_native_fast_path_band) ... ok
test_fps_is_single_color_at_all_rates_and_reuses_static_patches (test_hdmi_compare_layout.CompareLayoutTests.test_fps_is_single_color_at_all_rates_and_reuses_static_patches) ... ok
test_pixel_letterbox_is_identical_in_both_panels (test_hdmi_compare_layout.CompareLayoutTests.test_pixel_letterbox_is_identical_in_both_panels) ... ok
test_pixel_view_shared_pan_limits_and_matching_baseline_phase (test_hdmi_compare_layout.CompareLayoutTests.test_pixel_view_shared_pan_limits_and_matching_baseline_phase) ... ok
test_scale_badge_preserves_complete_captions_with_toolbar_shown_or_hidden (test_hdmi_compare_layout.CompareLayoutTests.test_scale_badge_preserves_complete_captions_with_toolbar_shown_or_hidden) ... ok
test_word_fill_is_byte_identical_and_keeps_strided_neighbors (test_hdmi_compare_layout.CompareLayoutTests.test_word_fill_is_byte_identical_and_keeps_strided_neighbors) ... ok

----------------------------------------------------------------------
Ran 190 tests in 72.596s

OK
