killua365/fpgachina2026-sr-lut/report/validation/reorganization_checks/ps_tests.txt

test_decoded_difference_cannot_be_hidden_by_summary_flags (test_audit_hdmi_business_pixels.DecodedPixelAuditTests.test_decoded_difference_cannot_be_hidden_by_summary_flags) ... ok
test_evidence_cannot_reference_outside_root (test_audit_hdmi_business_pixels.DecodedPixelAuditTests.test_evidence_cannot_reference_outside_root) ... ok
test_missing_package_never_certifies_reported_matches (test_audit_hdmi_business_pixels.DecodedPixelAuditTests.test_missing_package_never_certifies_reported_matches) ... ok
test_bad_length_and_wrong_channel_are_rejected (test_hdmi_acp_receive.AcpCompletionTests.test_bad_length_and_wrong_channel_are_rejected) ... ok
test_coherent_completion_requires_matching_bit_and_hwh (test_hdmi_acp_receive.AcpCompletionTests.test_coherent_completion_requires_matching_bit_and_hwh) ... ok
test_completes_same_buffer_without_software_invalidate (test_hdmi_acp_receive.AcpCompletionTests.test_completes_same_buffer_without_software_invalidate) ... ok
test_errors_preserve_buffer_for_owned_recovery (test_hdmi_acp_receive.AcpCompletionTests.test_errors_preserve_buffer_for_owned_recovery) ... ok
test_timeout_keeps_ownership (test_hdmi_acp_receive.AcpCompletionTests.test_timeout_keeps_ownership) ... ok
test_unknown_driver_uses_existing_completion (test_hdmi_acp_receive.AcpCompletionTests.test_unknown_driver_uses_existing_completion) ... ok
test_camera_geometry_must_respect_the_sr_contract (test_hdmi_camera.CameraTests.test_camera_geometry_must_respect_the_sr_contract) ... ok
test_cold_spawn_uses_open_timeout_then_stream_uses_read_timeout (test_hdmi_camera.CameraTests.test_cold_spawn_uses_open_timeout_then_stream_uses_read_timeout) ... ok
test_default_format_preserves_negotiated_full_resolution_and_rate (test_hdmi_camera.CameraTests.test_default_format_preserves_negotiated_full_resolution_and_rate) ... ok
test_failed_open_retries_automatically_without_a_button (test_hdmi_camera.CameraTests.test_failed_open_retries_automatically_without_a_button) ... ok
test_letterbox_preserves_four_by_three_geometry_and_rgb_order (test_hdmi_camera.CameraTests.test_letterbox_preserves_four_by_three_geometry_and_rgb_order) ... ok
test_mailbox_is_bounded_and_consumer_owns_copied_frame (test_hdmi_camera.CameraTests.test_mailbox_is_bounded_and_consumer_owns_copied_frame) ... ok
test_native_capture_checks_geometry_and_converts_before_area_filter (test_hdmi_camera.CameraTests.test_native_capture_checks_geometry_and_converts_before_area_filter) ... ok
test_native_capture_negotiation_retains_resolution_and_falls_back_if_rejected (test_hdmi_camera.CameraTests.test_native_capture_negotiation_retains_resolution_and_falls_back_if_rejected) ... ok
test_streaming_worker_failure_recovers_with_a_new_generation (test_hdmi_camera.CameraTests.test_streaming_worker_failure_recovers_with_a_new_generation) ... ok
test_stuck_read_is_retired_and_switching_mode_cancels_retry (test_hdmi_camera.CameraTests.test_stuck_read_is_retired_and_switching_mode_cancels_retry) ... ok
test_cancel_releases_ready_reservation_without_freeing_scanout (test_hdmi_camera_optimized.DirectCameraTests.test_cancel_releases_ready_reservation_without_freeing_scanout) ... ok
test_checked_copy_matches_compositor_and_rejects_discarded_pixel_corruption (test_hdmi_camera_optimized.DirectCameraTests.test_checked_copy_matches_compositor_and_rejects_discarded_pixel_corruption) ... ok
test_corrupt_last_x_byte_never_reaches_vdma (test_hdmi_camera_optimized.DirectCameraTests.test_corrupt_last_x_byte_never_reaches_vdma) ... ok
test_rotation_overlap_and_repaint_regenerate_clean_sr (test_hdmi_camera_optimized.DirectCameraTests.test_rotation_overlap_and_repaint_regenerate_clean_sr) ... ok
test_split_partial_repaint_matches_full_and_invalidates_for_pointer_change (test_hdmi_camera_optimized.DirectCameraTests.test_split_partial_repaint_matches_full_and_invalidates_for_pointer_change) ... ok
test_area_pixels_match_opencv_with_padding_patterns_and_random_frames (test_hdmi_camera_optimized.NativeAreaTests.test_area_pixels_match_opencv_with_padding_patterns_and_random_frames) ... skipped 'ARM native library required'
test_camera_restart_drops_pending_old_generation (test_hdmi_camera_pipeline.CameraPipelineTests.test_camera_restart_drops_pending_old_generation) ... ok
test_idle_and_scale_transition_discard_pending_and_close_borrowed_storage (test_hdmi_camera_pipeline.CameraPipelineTests.test_idle_and_scale_transition_discard_pending_and_close_borrowed_storage) ... ok
test_overlap_preserves_matching_source_and_output_and_expires_old_slot (test_hdmi_camera_pipeline.CameraPipelineTests.test_overlap_preserves_matching_source_and_output_and_expires_old_slot) ... ok
test_exact_pixels_strides_guards_and_all_discarded_positions (test_hdmi_checked_copy.CheckedCopyTests.test_exact_pixels_strides_guards_and_all_discarded_positions) ... ok
test_invalid_geometry_and_aliasing (test_hdmi_checked_copy.CheckedCopyTests.test_invalid_geometry_and_aliasing) ... ok
test_actual_frame_edges_anchor_normal_and_narrow_image_captions (test_hdmi_compare_layout.CompareLayoutTests.test_actual_frame_edges_anchor_normal_and_narrow_image_captions) ... ok
test_all_shapes_keep_captions_and_fps_outside_pictures_and_toolbar (test_hdmi_compare_layout.CompareLayoutTests.test_all_shapes_keep_captions_and_fps_outside_pictures_and_toolbar) ... ok
test_camera_fit_retains_exact_native_fast_path_band (test_hdmi_compare_layout.CompareLayoutTests.test_camera_fit_retains_exact_native_fast_path_band) ... ok
test_fps_is_single_color_at_all_rates_and_reuses_static_patches (test_hdmi_compare_layout.CompareLayoutTests.test_fps_is_single_color_at_all_rates_and_reuses_static_patches) ... ok
test_pixel_letterbox_is_identical_in_both_panels (test_hdmi_compare_layout.CompareLayoutTests.test_pixel_letterbox_is_identical_in_both_panels) ... ok
test_pixel_view_shared_pan_limits_and_matching_baseline_phase (test_hdmi_compare_layout.CompareLayoutTests.test_pixel_view_shared_pan_limits_and_matching_baseline_phase) ... ok
test_scale_badge_preserves_complete_captions_with_toolbar_shown_or_hidden (test_hdmi_compare_layout.CompareLayoutTests.test_scale_badge_preserves_complete_captions_with_toolbar_shown_or_hidden) ... ok
test_word_fill_is_byte_identical_and_keeps_strided_neighbors (test_hdmi_compare_layout.CompareLayoutTests.test_word_fill_is_byte_identical_and_keeps_strided_neighbors) ... ok
test_all_modes_and_all_switch_values (test_hdmi_controls.ControlTests.test_all_modes_and_all_switch_values) ... ok
test_bounce_does_not_switch_and_held_button_does_not_repeat (test_hdmi_controls.ControlTests.test_bounce_does_not_switch_and_held_button_does_not_repeat) ... ok
test_reset_wins_simultaneous_button_press (test_hdmi_controls.ControlTests.test_reset_wins_simultaneous_button_press) ... ok
test_switch_and_button_debounce_are_independent (test_hdmi_controls.ControlTests.test_switch_and_button_debounce_are_independent) ... ok
test_cancelled_run_writes_failure_without_starting_hardware (test_hdmi_diagnostics.DiagnosticsTests.test_cancelled_run_writes_failure_without_starting_hardware) ... ok
test_lost_lock_saturation_underflow_and_frozen_pointer_fail (test_hdmi_diagnostics.DiagnosticsTests.test_lost_lock_saturation_underflow_and_frozen_pointer_fail) ... ok
test_observation_retains_live_buffers_and_continues_frames_until_stop (test_hdmi_diagnostics.DiagnosticsTests.test_observation_retains_live_buffers_and_continues_frames_until_stop) ... ok
test_run_saves_native_patterns_but_does_not_claim_monitor_acceptance (test_hdmi_diagnostics.DiagnosticsTests.test_run_saves_native_patterns_but_does_not_claim_monitor_acceptance) ... ok
test_wrap_and_repeated_scans_are_not_new_processed_frames (test_hdmi_diagnostics.DiagnosticsTests.test_wrap_and_repeated_scans_are_not_new_processed_frames) ... ok
test_invalid_wipe_rejected (test_hdmi_display.CompositionTests.test_invalid_wipe_rejected) ... ok
test_pixel_pan_keeps_views_aligned (test_hdmi_display.CompositionTests.test_pixel_pan_keeps_views_aligned) ... ok
test_sources_are_not_modified (test_hdmi_display.CompositionTests.test_sources_are_not_modified) ... ok
test_split_has_same_geometry_and_no_color_swap (test_hdmi_display.CompositionTests.test_split_has_same_geometry_and_no_color_swap) ... ok
test_virtual_baseline_crop_matches_expanded_pixels_at_all_scale_phases (test_hdmi_display.CompositionTests.test_virtual_baseline_crop_matches_expanded_pixels_at_all_scale_phases) ... ok
test_wipe_preserves_corresponding_pixels (test_hdmi_display.CompositionTests.test_wipe_preserves_corresponding_pixels) ... ok
test_fabricated_sequence_and_wrong_geometry_rejected (test_hdmi_display.FrameTests.test_fabricated_sequence_and_wrong_geometry_rejected) ... ok
test_outdated_and_duplicate_frames_do_not_publish (test_hdmi_display.FrameTests.test_outdated_and_duplicate_frames_do_not_publish) ... ok
test_full_image_display_rect_and_bad_dimension (test_hdmi_display.GeometryTests.test_full_image_display_rect_and_bad_dimension) ... ok
test_letterbox_maps_to_original_not_thumbnail (test_hdmi_display.GeometryTests.test_letterbox_maps_to_original_not_thumbnail) ... ok
test_padding_click_and_hardware_limit_rejected (test_hdmi_display.GeometryTests.test_padding_click_and_hardware_limit_rejected) ... ok
test_single_pixel_roi_and_reverse_drag (test_hdmi_display.GeometryTests.test_single_pixel_roi_and_reverse_drag) ... ok
test_halt_failure_prevents_overlay_replacement (test_hdmi_engine.EngineTests.test_halt_failure_prevents_overlay_replacement) ... ok
test_mode_change_rejects_old_pair_and_geometry_change_closes_session (test_hdmi_engine.EngineTests.test_mode_change_rejects_old_pair_and_geometry_change_closes_session) ... ok
test_modes_reuse_same_scale_and_camera_stays_x4 (test_hdmi_engine.EngineTests.test_modes_reuse_same_scale_and_camera_stays_x4) ... ok
test_roi_uses_original_pixels_and_exact_halo_crop (test_hdmi_engine.EngineTests.test_roi_uses_original_pixels_and_exact_halo_crop) ... ok
test_all_frames_have_raw_hashes_and_separate_lossy_validation (test_hdmi_export.ExportTests.test_all_frames_have_raw_hashes_and_separate_lossy_validation) ... ok
test_cancel_and_bad_geometry_remove_partial_export (test_hdmi_export.ExportTests.test_cancel_and_bad_geometry_remove_partial_export) ... ok
test_validation_export_retains_the_actual_preencode_stream (test_hdmi_export.ExportTests.test_validation_export_retains_the_actual_preencode_stream) ... ok
test_bad_crc_bad_complement_and_incomplete_marker_rejected (test_hdmi_frame_marker.MarkerTests.test_bad_crc_bad_complement_and_incomplete_marker_rejected) ... ok
test_composition_only_stable_on_repaint_and_no_result_on_idle (test_hdmi_frame_marker.MarkerTests.test_composition_only_stable_on_repaint_and_no_result_on_idle) ... ok
test_known_wire_bytes_and_semantics (test_hdmi_frame_marker.MarkerTests.test_known_wire_bytes_and_semantics) ... ok
test_complete_png_export_is_readable_under_private_umask (test_hdmi_image_export.ImageExportTests.test_complete_png_export_is_readable_under_private_umask) ... skipped 'Checks Linux collector permissions'
test_png_is_exact_and_no_reference_does_not_claim_quality (test_hdmi_image_export.ImageExportTests.test_png_is_exact_and_no_reference_does_not_claim_quality) ... ok
test_true_reference_is_required_and_metrics_use_native_result (test_hdmi_image_export.ImageExportTests.test_true_reference_is_required_and_metrics_use_native_result) ... ok
test_cancel_while_encoder_running_reaps_only_owned_process (test_hdmi_interactive_export.InteractiveExportTests.test_cancel_while_encoder_running_reaps_only_owned_process) ... ok
test_cancel_while_probe_running_remains_responsive (test_hdmi_interactive_export.InteractiveExportTests.test_cancel_while_probe_running_remains_responsive) ... ok
test_mouse_export_action_binds_overlay_and_package (test_hdmi_interactive_export.InteractiveExportTests.test_mouse_export_action_binds_overlay_and_package) ... ok
test_one_frame_per_tick_same_thread_and_cancel_keeps_display (test_hdmi_interactive_export.InteractiveExportTests.test_one_frame_per_tick_same_thread_and_cancel_keeps_display) ... ok
test_physical_scale_change_cancels_before_reload (test_hdmi_interactive_export.InteractiveExportTests.test_physical_scale_change_cancels_before_reload) ... ok
test_playback_actions_blocked_and_button_fits_display (test_hdmi_interactive_export.InteractiveExportTests.test_playback_actions_blocked_and_button_fits_display) ... ok
test_processing_dma_fault_is_propagated_for_ordered_shutdown (test_hdmi_interactive_export.InteractiveExportTests.test_processing_dma_fault_is_propagated_for_ordered_shutdown) ... ok
test_real_encode_both_scales_includes_every_frame_and_keeps_playback_paused (test_hdmi_interactive_export.InteractiveExportTests.test_real_encode_both_scales_includes_every_frame_and_keeps_playback_paused) ... ok
test_storage_failure_does_not_fault_hardware_or_leave_partial_output (test_hdmi_interactive_export.InteractiveExportTests.test_storage_failure_does_not_fault_hardware_or_leave_partial_output) ... ok
test_window_exit_closes_export_before_clip (test_hdmi_interactive_export.InteractiveExportTests.test_window_exit_closes_export_before_clip) ... ok
test_write_failure_removes_partial_export_and_can_retry (test_hdmi_interactive_export.InteractiveExportTests.test_write_failure_removes_partial_export_and_can_retry) ... ok
test_cancel_decoding_removes_partial_file_and_keeps_old_video (test_hdmi_interactive_import.InteractiveImportTests.test_cancel_decoding_removes_partial_file_and_keeps_old_video) ... ok
test_cancel_verification_and_changed_source_are_not_published (test_hdmi_interactive_import.InteractiveImportTests.test_cancel_verification_and_changed_source_are_not_published) ... ok
test_decoder_failure_cleans_partial_output (test_hdmi_interactive_import.InteractiveImportTests.test_decoder_failure_cleans_partial_output) ... ok
test_insufficient_space_never_starts_decoder (test_hdmi_interactive_import.InteractiveImportTests.test_insufficient_space_never_starts_decoder) ... ok
test_missing_media_path_is_visible_and_import_keeps_old_video (test_hdmi_interactive_import.InteractiveImportTests.test_missing_media_path_is_visible_and_import_keeps_old_video) ... ok
test_mouse_picker_selects_file_and_mutual_exclusion (test_hdmi_interactive_import.InteractiveImportTests.test_mouse_picker_selects_file_and_mutual_exclusion) ... ok
test_physical_control_cancels_probe_before_mode_switch (test_hdmi_interactive_import.InteractiveImportTests.test_physical_control_cancels_probe_before_mode_switch) ... ok
test_real_h264_and_mjpeg_normalize_to_dual_board_geometry (test_hdmi_interactive_import.InteractiveImportTests.test_real_h264_and_mjpeg_normalize_to_dual_board_geometry) ... ok
test_unsupported_codec_or_bit_depth_never_replaces_clip (test_hdmi_interactive_import.InteractiveImportTests.test_unsupported_codec_or_bit_depth_never_replaces_clip) ... ok
test_large_directory_is_bounded_and_path_cannot_escape_root (test_hdmi_interactive_import.PickerTests.test_large_directory_is_bounded_and_path_cannot_escape_root) ... ok
test_navigation_paging_filtering_and_missing_file (test_hdmi_interactive_import.PickerTests.test_navigation_paging_filtering_and_missing_file) ... ok
test_mjpeg_import_leaves_no_partial_directory (test_hdmi_media.LocalImportTests.test_mjpeg_import_leaves_no_partial_directory) ... ok
test_precancel_never_starts_decoder_or_creates_output (test_hdmi_media.LocalImportTests.test_precancel_never_starts_decoder_or_creates_output) ... ok
test_real_h264_import_random_seek_and_tamper (test_hdmi_media.LocalImportTests.test_real_h264_import_random_seek_and_tamper) ... ok
test_all_real_pairs_and_roi_match_scale_specific_hr (test_hdmi_metrics.MetricTests.test_all_real_pairs_and_roi_match_scale_specific_hr) ... ok
test_atomic_switch_loads_new_lr_before_processing (test_hdmi_metrics.MetricTests.test_atomic_switch_loads_new_lr_before_processing) ... ok
test_fps_window_repaints_freeze_disconnect_and_generation (test_hdmi_metrics.MetricTests.test_fps_window_repaints_freeze_disconnect_and_generation) ... ok
test_quality_worker_drops_old_result (test_hdmi_metrics.MetricTests.test_quality_worker_drops_old_result) ... ok
test_small_cached_header_changes_with_dimensions_and_signed_delta (test_hdmi_metrics.MetricTests.test_small_cached_header_changes_with_dimensions_and_signed_delta) ... ok
test_input_flood_cannot_starve_render_loop (test_hdmi_mouse.MouseTests.test_input_flood_cannot_starve_render_loop) ... ok
test_lost_events_resync_buttons_and_ignore_corrupt_relative_deltas (test_hdmi_mouse.MouseTests.test_lost_events_resync_buttons_and_ignore_corrupt_relative_deltas) ... ok
test_motion_clamps_and_click_repeat_does_not_double_count (test_hdmi_mouse.MouseTests.test_motion_clamps_and_click_repeat_does_not_double_count) ... ok
test_unplug_clears_held_button_and_reconnect_is_rate_limited (test_hdmi_mouse.MouseTests.test_unplug_clears_held_button_and_reconnect_is_rate_limited) ... ok
test_borrowed_rgbx_view_matches_owned_rgb_for_all_compositions (test_hdmi_pixels.NativePixelTests.test_borrowed_rgbx_view_matches_owned_rgb_for_all_compositions) ... ok
test_composition_matches_numpy_copies_for_all_layouts_and_pans (test_hdmi_pixels.NativePixelTests.test_composition_matches_numpy_copies_for_all_layouts_and_pans) ... ok
test_direct_rgbx_validation_includes_every_vector_lane_and_tail (test_hdmi_pixels.NativePixelTests.test_direct_rgbx_validation_includes_every_vector_lane_and_tail) ... ok
test_fit_baseline_matches_two_stage_nearest_sampling (test_hdmi_pixels.NativePixelTests.test_fit_baseline_matches_two_stage_nearest_sampling) ... ok
test_fused_layout_clears_old_margins_and_matches_portable_fit (test_hdmi_pixels.NativePixelTests.test_fused_layout_clears_old_margins_and_matches_portable_fit) ... ok
test_fused_paint_sampling_stride_and_guard_pixels (test_hdmi_pixels.NativePixelTests.test_fused_paint_sampling_stride_and_guard_pixels) ... skipped 'New fused ARM painter exercised on the board'
test_fused_validation_checks_vector_lanes_and_scalar_tail (test_hdmi_pixels.NativePixelTests.test_fused_validation_checks_vector_lanes_and_scalar_tail) ... skipped 'ARM native library exercised separately on the board'
test_half_size_paint_actual_camera_geometry_and_vector_tails (test_hdmi_pixels.NativePixelTests.test_half_size_paint_actual_camera_geometry_and_vector_tails) ... skipped 'ARM native library exercised on the board'
test_input_pack_overwrites_all_x_without_changing_rgb (test_hdmi_pixels.NativePixelTests.test_input_pack_overwrites_all_x_without_changing_rgb) ... ok
test_panel_stride_singletons_and_x_byte_preserved (test_hdmi_pixels.NativePixelTests.test_panel_stride_singletons_and_x_byte_preserved) ... ok
test_session_retains_full_word_validation (test_hdmi_pixels.NativePixelTests.test_session_retains_full_word_validation) ... ok
test_unpack_owns_result_and_preserves_rgb_order (test_hdmi_pixels.NativePixelTests.test_unpack_owns_result_and_preserves_rgb_order) ... ok
test_yuyv_matches_opencv_with_saturation_strides_and_vector_tails (test_hdmi_pixels.NativePixelTests.test_yuyv_matches_opencv_with_saturation_strides_and_vector_tails) ... ok
test_end_loop_and_restart (test_hdmi_playback.PlaybackTests.test_end_loop_and_restart) ... ok
test_out_of_order_completion_is_rejected (test_hdmi_playback.PlaybackTests.test_out_of_order_completion_is_rejected) ... ok
test_pause_step_and_no_duplicate_processing (test_hdmi_playback.PlaybackTests.test_pause_step_and_no_duplicate_processing) ... ok
test_seek_scale_and_source_reject_old_results (test_hdmi_playback.PlaybackTests.test_seek_scale_and_source_reject_old_results) ... ok
test_speed_change_keeps_position_and_real_time_can_skip (test_hdmi_playback.PlaybackTests.test_speed_change_keeps_position_and_real_time_can_skip) ... ok
test_request_is_explicit_run_bound_and_one_shot (test_hdmi_presentation.CampaignRequestTests.test_request_is_explicit_run_bound_and_one_shot) ... ok
test_camera_restart_while_frozen_keeps_owned_snapshot (test_hdmi_presentation.FreezeTests.test_camera_restart_while_frozen_keeps_owned_snapshot) ... ok
test_invalid_borrowed_frame_or_hidden_corruption_cannot_freeze (test_hdmi_presentation.FreezeTests.test_invalid_borrowed_frame_or_hidden_corruption_cannot_freeze) ... ok
test_mode_change_releases_freeze_and_resets_view (test_hdmi_presentation.FreezeTests.test_mode_change_releases_freeze_and_resets_view) ... ok
test_no_frame_does_not_freeze (test_hdmi_presentation.FreezeTests.test_no_frame_does_not_freeze) ... ok
test_resume_discards_old_capture_and_restarts_identity (test_hdmi_presentation.FreezeTests.test_resume_discards_old_capture_and_restarts_identity) ... ok
test_saving_blocks_resume_and_duplicate_but_can_cancel (test_hdmi_presentation.FreezeTests.test_saving_blocks_resume_and_duplicate_but_can_cancel) ... ok
test_snapshot_exports_exact_same_frame_with_comparison (test_hdmi_presentation.FreezeTests.test_snapshot_exports_exact_same_frame_with_comparison) ... ok
test_snapshot_owns_last_displayed_pair_and_does_not_count_repaints (test_hdmi_presentation.FreezeTests.test_snapshot_owns_last_displayed_pair_and_does_not_count_repaints) ... ok
test_dropped_event_cancels_drag_without_a_stale_release_commit (test_hdmi_presentation.ViewInteractionTests.test_dropped_event_cancels_drag_without_a_stale_release_commit) ... ok
test_dynamic_pan_and_wipe_do_not_rebuild_static_camera_overlay (test_hdmi_presentation.ViewInteractionTests.test_dynamic_pan_and_wipe_do_not_rebuild_static_camera_overlay) ... ok
test_view_label_highlight_and_reset_do_not_change_roi (test_hdmi_presentation.ViewInteractionTests.test_view_label_highlight_and_reset_do_not_change_roi) ... ok
test_wipe_caps_and_handle_stay_inside_picture_and_above_toolbar (test_hdmi_presentation.ViewInteractionTests.test_wipe_caps_and_handle_stay_inside_picture_and_above_toolbar) ... ok
test_wipe_drag_uses_content_bounds_and_release_coordinate (test_hdmi_presentation.ViewInteractionTests.test_wipe_drag_uses_content_bounds_and_release_coordinate) ... ok
test_wipe_line_reaches_visible_picture_bottom_in_all_modes (test_hdmi_presentation.ViewInteractionTests.test_wipe_line_reaches_visible_picture_bottom_in_all_modes) ... ok
test_cached_wipe_matches_independent_reference_all_pan_phases (test_hdmi_presentation.WipeTests.test_cached_wipe_matches_independent_reference_all_pan_phases) ... ok
test_cancelled_export_leaves_no_completed_or_partial_directory (test_hdmi_presentation.WipeTests.test_cancelled_export_leaves_no_completed_or_partial_directory) ... ok
test_fused_wipe_cuts_padding_and_hidden_x_validation (test_hdmi_presentation.WipeTests.test_fused_wipe_cuts_padding_and_hidden_x_validation) ... ok
test_wipe_input_validation (test_hdmi_presentation.WipeTests.test_wipe_input_validation) ... ok
test_cancel_terminates_running_process (test_hdmi_process.ProcessTests.test_cancel_terminates_running_process) ... ok
test_timeout_and_exit_status_propagate (test_hdmi_process.ProcessTests.test_timeout_and_exit_status_propagate) ... ok
test_1080_ui_hit_boxes_wipe_and_draw_use_same_canvas (test_hdmi_profiles.ProfileIntegrationTests.test_1080_ui_hit_boxes_wipe_and_draw_use_same_canvas) ... ok
test_30hz_pynq_profile_cannot_claim_nexys_fps (test_hdmi_profiles.ProfileIntegrationTests.test_30hz_pynq_profile_cannot_claim_nexys_fps) ... ok
test_camera_roi_and_import_share_profile_geometry (test_hdmi_profiles.ProfileIntegrationTests.test_camera_roi_and_import_share_profile_geometry) ... ok
test_manifest_needs_complete_matching_dual_profile (test_hdmi_profiles.ProfileIntegrationTests.test_manifest_needs_complete_matching_dual_profile) ... ok
test_real_output_sizes_repaint_and_same_scale_mode_reuse (test_hdmi_profiles.ProfileIntegrationTests.test_real_output_sizes_repaint_and_same_scale_mode_reuse) ... ok
test_counter_reset_underflow_and_source_change_fail (test_hdmi_profiling.ProfilingTests.test_counter_reset_underflow_and_source_change_fail) ... ok
test_counts_only_acknowledged_pairs_and_retains_startup_counters (test_hdmi_profiling.ProfilingTests.test_counts_only_acknowledged_pairs_and_retains_startup_counters) ... ok
test_repeated_scans_and_ui_repaints_cannot_pass_fps (test_hdmi_profiling.ProfilingTests.test_repeated_scans_and_ui_repaints_cannot_pass_fps) ... ok
test_camera_fixed_scale_and_idle_stop_preserve_display (test_hdmi_runtime.RuntimeTests.test_camera_fixed_scale_and_idle_stop_preserve_display) ... ok
test_camera_recovery_invalidates_old_frame_generation (test_hdmi_runtime.RuntimeTests.test_camera_recovery_invalidates_old_frame_generation) ... ok
test_idle_repaints_surface_and_cannot_count_as_processing (test_hdmi_runtime.RuntimeTests.test_idle_repaints_surface_and_cannot_count_as_processing) ... ok
test_image_repaint_does_not_reprocess_or_count_a_new_source_frame (test_hdmi_runtime.RuntimeTests.test_image_repaint_does_not_reprocess_or_count_a_new_source_frame) ... ok
test_roi_change_rejects_previous_generation_and_uses_original_pixels (test_hdmi_runtime.RuntimeTests.test_roi_change_rejects_previous_generation_and_uses_original_pixels) ... ok
test_status_separates_processing_and_new_frame_rates (test_hdmi_runtime.RuntimeTests.test_status_separates_processing_and_new_frame_rates) ... ok
test_video_seek_and_exact_step_bind_matching_frame_pairs (test_hdmi_runtime.RuntimeTests.test_video_seek_and_exact_step_bind_matching_frame_pairs) ... ok
test_1080p_timing_uses_cea_progressive_porches_for_both_rates (test_hdmi_scanout.ScanoutTests.test_1080p_timing_uses_cea_progressive_porches_for_both_rates) ... ok
test_720p_timing_reconstructs_standard_clock_and_sync (test_hdmi_scanout.ScanoutTests.test_720p_timing_reconstructs_standard_clock_and_sync) ... ok
test_cache_flush_precedes_submit_and_duplicate_lease_is_rejected (test_hdmi_scanout.ScanoutTests.test_cache_flush_precedes_submit_and_duplicate_lease_is_rejected) ... ok
test_direct_camera_reservations_do_not_alias_active_pending_or_ready (test_hdmi_scanout.ScanoutTests.test_direct_camera_reservations_do_not_alias_active_pending_or_ready) ... ok
test_dma_errors_are_not_silently_cleared (test_hdmi_scanout.ScanoutTests.test_dma_errors_are_not_silently_cleared) ... ok
test_failed_stop_retains_memory_until_later_confirmed_halt (test_hdmi_scanout.ScanoutTests.test_failed_stop_retains_memory_until_later_confirmed_halt) ... ok
test_overlay_factory_uses_mmio_without_binding_interrupt_driver (test_hdmi_scanout.ScanoutTests.test_overlay_factory_uses_mmio_without_binding_interrupt_driver) ... ok
test_ranged_sync_uses_exact_rows_and_rejects_out_of_bounds (test_hdmi_scanout.ScanoutTests.test_ranged_sync_uses_exact_rows_and_rejects_out_of_bounds) ... ok
test_running_dma_is_not_stolen (test_hdmi_scanout.ScanoutTests.test_running_dma_is_not_stolen) ... ok
test_source_counts_require_hardware_ack_and_exclude_ui_and_repeat_pairs (test_hdmi_scanout.ScanoutTests.test_source_counts_require_hardware_ack_and_exclude_ui_and_repeat_pairs) ... ok
test_three_buffers_do_not_recycle_scanning_or_pending (test_hdmi_scanout.ScanoutTests.test_three_buffers_do_not_recycle_scanning_or_pending) ... ok
test_halt_failure_prevents_overlay_replacement (test_hdmi_engine.EngineTests.test_halt_failure_prevents_overlay_replacement) ... ok
test_mode_change_rejects_old_pair_and_geometry_change_closes_session (test_hdmi_engine.EngineTests.test_mode_change_rejects_old_pair_and_geometry_change_closes_session) ... ok
test_modes_reuse_same_scale_and_camera_stays_x4 (test_hdmi_engine.EngineTests.test_modes_reuse_same_scale_and_camera_stays_x4) ... ok
test_roi_uses_original_pixels_and_exact_halo_crop (test_hdmi_engine.EngineTests.test_roi_uses_original_pixels_and_exact_halo_crop) ... ok
test_failed_submit_and_failed_trace_cannot_fake_success (test_hdmi_session_trace.ObserverTests.test_failed_submit_and_failed_trace_cannot_fake_success) ... ok
test_observer_follows_submission_and_rejects_stale_pair (test_hdmi_session_trace.ObserverTests.test_observer_follows_submission_and_rejects_stale_pair) ... ok
test_launch_rejects_foreign_path_and_unbounded_profiles_before_hardware (test_hdmi_session_trace.TraceTests.test_launch_rejects_foreign_path_and_unbounded_profiles_before_hardware) ... ok
test_repaint_mode_generation_and_regression (test_hdmi_session_trace.TraceTests.test_repaint_mode_generation_and_regression) ... ok
test_camera_cached_overlay_matches_drawing_and_preserves_background (test_hdmi_workspace.WorkspaceTests.test_camera_cached_overlay_matches_drawing_and_preserves_background) ... ok
test_camera_content_band_only_excludes_fully_opaque_rows (test_hdmi_workspace.WorkspaceTests.test_camera_content_band_only_excludes_fully_opaque_rows) ... ok
test_cursor_motion_repaints_static_image_without_processing (test_hdmi_workspace.WorkspaceTests.test_cursor_motion_repaints_static_image_without_processing) ... ok
test_disconnect_cancels_drag_instead_of_committing_a_phantom_roi (test_hdmi_workspace.WorkspaceTests.test_disconnect_cancels_drag_instead_of_committing_a_phantom_roi) ... ok
test_export_decodes_exact_pixels_and_no_reference_quality_is_invented (test_hdmi_workspace.WorkspaceTests.test_export_decodes_exact_pixels_and_no_reference_quality_is_invented) ... ok
test_manual_session_has_no_short_countdown (test_hdmi_workspace.WorkspaceTests.test_manual_session_has_no_short_countdown) ... ok
test_moving_cursor_reuses_static_overlay_but_invalidates_slot_key (test_hdmi_workspace.WorkspaceTests.test_moving_cursor_reuses_static_overlay_but_invalidates_slot_key) ... ok
test_partial_camera_band_restores_pointer_over_content (test_hdmi_workspace.WorkspaceTests.test_partial_camera_band_restores_pointer_over_content) ... ok
test_roi_move_commits_original_coordinates_only_on_release (test_hdmi_workspace.WorkspaceTests.test_roi_move_commits_original_coordinates_only_on_release) ... ok
test_save_failure_has_visible_error_without_false_success (test_hdmi_workspace.WorkspaceTests.test_save_failure_has_visible_error_without_false_success) ... ok
test_save_feedback_remains_visible_when_toolbar_hides_and_is_reported (test_hdmi_workspace.WorkspaceTests.test_save_feedback_remains_visible_when_toolbar_hides_and_is_reported) ... ok
test_selection_background_cached_and_invalidated_on_new_image (test_hdmi_workspace.WorkspaceTests.test_selection_background_cached_and_invalidated_on_new_image) ... ok
test_selection_cached_pixels_match_reference_with_notice_and_roi_changes (test_hdmi_workspace.WorkspaceTests.test_selection_cached_pixels_match_reference_with_notice_and_roi_changes) ... ok
test_selection_repaint_skips_hidden_sr_composition (test_hdmi_workspace.WorkspaceTests.test_selection_repaint_skips_hidden_sr_composition) ... ok
test_session_countdown_does_not_depend_on_toolbar_visibility (test_hdmi_workspace.WorkspaceTests.test_session_countdown_does_not_depend_on_toolbar_visibility) ... ok
test_short_click_changes_layout_without_changing_physical_mode_or_scale (test_hdmi_workspace.WorkspaceTests.test_short_click_changes_layout_without_changing_physical_mode_or_scale) ... ok
test_single_pixel_roi_displays_and_exports_on_board_opencv (test_hdmi_workspace.WorkspaceTests.test_single_pixel_roi_displays_and_exports_on_board_opencv) ... ok
test_479_pixel_roi_at_source_edge_is_allowed (test_roi_geometry.RoiGeometryTests.test_479_pixel_roi_at_source_edge_is_allowed) ... ok
test_boolean_coordinates_are_rejected (test_roi_geometry.RoiGeometryTests.test_boolean_coordinates_are_rejected) ... ok
test_bottom_right_uses_true_image_boundary (test_roi_geometry.RoiGeometryTests.test_bottom_right_uses_true_image_boundary) ... ok
test_full_320_frame_is_allowed (test_roi_geometry.RoiGeometryTests.test_full_320_frame_is_allowed) ... ok
test_internal_479_pixel_roi_is_too_wide (test_roi_geometry.RoiGeometryTests.test_internal_479_pixel_roi_is_too_wide) ... ok
test_internal_roi_has_one_pixel_context (test_roi_geometry.RoiGeometryTests.test_internal_roi_has_one_pixel_context) ... ok
test_roi_must_be_inside_source (test_roi_geometry.RoiGeometryTests.test_roi_must_be_inside_source) ... ok
test_small_roi_expands_to_minimum_window (test_roi_geometry.RoiGeometryTests.test_small_roi_expands_to_minimum_window) ... ok
test_source_minimum_is_enforced (test_roi_geometry.RoiGeometryTests.test_source_minimum_is_enforced) ... ok
test_top_left_uses_true_image_boundary (test_roi_geometry.RoiGeometryTests.test_top_left_uses_true_image_boundary) ... ok
test_hardware_result_is_cropped_to_exact_roi (test_roi_processor.RoiProcessorTests.test_hardware_result_is_cropped_to_exact_roi) ... ok
test_invalid_source_type_is_rejected (test_roi_processor.RoiProcessorTests.test_invalid_source_type_is_rejected) ... ok
test_large_source_can_use_bounded_roi (test_roi_processor.RoiProcessorTests.test_large_source_can_use_bounded_roi) ... ok
test_overlay_is_loaded_lazily_once (test_roi_processor.RoiProcessorTests.test_overlay_is_loaded_lazily_once) ... ok
test_prepare_loads_hardware_once_on_calling_thread (test_roi_processor.RoiProcessorTests.test_prepare_loads_hardware_once_on_calling_thread) ... ok
test_preview_is_explicitly_non_formal (test_roi_processor.RoiProcessorTests.test_preview_is_explicitly_non_formal) ... ok
test_reconfiguration_lock_covers_loader_but_not_frame_execution (test_roi_processor.RoiProcessorTests.test_reconfiguration_lock_covers_loader_but_not_frame_execution) ... ok
test_switching_scale_reloads_the_previous_overlay (test_roi_processor.RoiProcessorTests.test_switching_scale_reloads_the_previous_overlay) ... ok
test_wrong_runner_shape_is_rejected (test_roi_processor.RoiProcessorTests.test_wrong_runner_shape_is_rejected) ... ok
test_x4_candidate_overlay_can_be_selected_by_environment (test_roi_processor.RoiProcessorTests.test_x4_candidate_overlay_can_be_selected_by_environment) ... ok
test_comparison_reports_fpga_minus_nearest_delta (test_roi_quality.RoiQualityTests.test_comparison_reports_fpga_minus_nearest_delta) ... ok
test_hr_crop_maps_lr_coordinates_by_four (test_roi_quality.RoiQualityTests.test_hr_crop_maps_lr_coordinates_by_four) ... ok
test_identical_comparisons_have_zero_deltas (test_roi_quality.RoiQualityTests.test_identical_comparisons_have_zero_deltas) ... ok
test_identical_images_have_perfect_metrics (test_roi_quality.RoiQualityTests.test_identical_images_have_perfect_metrics) ... ok
test_nearest_output_uses_dynamic_x4_dimensions (test_roi_quality.RoiQualityTests.test_nearest_output_uses_dynamic_x4_dimensions) ... ok
test_rgb_metrics_capture_colour_only_change (test_roi_quality.RoiQualityTests.test_rgb_metrics_capture_colour_only_change) ... ok
test_ssim_optimization_preserves_fixed_contract_values (test_roi_quality.RoiQualityTests.test_ssim_optimization_preserves_fixed_contract_values) ... ok
test_tiny_roi_reports_unavailable_formal_metrics (test_roi_quality.RoiQualityTests.test_tiny_roi_reports_unavailable_formal_metrics) ... ok
test_compare_reports_exact_match_and_error (test_sr_lut_x4_driver.DriverTests.test_compare_reports_exact_match_and_error) ... ok
test_geometry_and_pack_unpack_contract (test_sr_lut_x4_driver.DriverTests.test_geometry_and_pack_unpack_contract) ... ok
test_hwh_contains_dma_and_pl_performance_registers (test_sr_lut_x4_driver.DriverTests.test_hwh_contains_dma_and_pl_performance_registers) ... ok
test_load_overlay_uses_x4_bitstream (test_sr_lut_x4_driver.DriverTests.test_load_overlay_uses_x4_bitstream) ... ok
test_reads_pl_counters_without_using_host_timing (test_sr_lut_x4_driver.DriverTests.test_reads_pl_counters_without_using_host_timing) ... ok
test_rejects_out_of_range_or_invalid_input (test_sr_lut_x4_driver.DriverTests.test_rejects_out_of_range_or_invalid_input) ... ok
test_run_frame_arms_receive_before_send_and_syncs_buffers (test_sr_lut_x4_driver.DriverTests.test_run_frame_arms_receive_before_send_and_syncs_buffers) ... ok
test_timeout_is_reported (test_sr_lut_x4_driver.DriverTests.test_timeout_is_reported) ... ok
test_converter_backend_selection_and_native_fallback (test_video_pipeline.VideoPipelineTests.test_converter_backend_selection_and_native_fallback) ... ok
test_converter_falls_back_only_in_auto_mode (test_video_pipeline.VideoPipelineTests.test_converter_falls_back_only_in_auto_mode) ... ok
test_converter_rejects_non_contiguous_input (test_video_pipeline.VideoPipelineTests.test_converter_rejects_non_contiguous_input) ... ok
test_external_display_allocations_are_not_freed_by_sr_session (test_video_pipeline.VideoPipelineTests.test_external_display_allocations_are_not_freed_by_sr_session) ... ok
test_frame_session_exposes_mb420_words_and_hardware_crc (test_video_pipeline.VideoPipelineTests.test_frame_session_exposes_mb420_words_and_hardware_crc) ... ok
test_frame_session_exposes_owned_zero_copy_dma_slots (test_video_pipeline.VideoPipelineTests.test_frame_session_exposes_owned_zero_copy_dma_slots) ... ok
test_frame_session_requires_cacheable_acp_output_buffers (test_video_pipeline.VideoPipelineTests.test_frame_session_requires_cacheable_acp_output_buffers) ... ok
test_frame_session_reuses_dma_buffers_and_preserves_rgbx (test_video_pipeline.VideoPipelineTests.test_frame_session_reuses_dma_buffers_and_preserves_rgbx) ... ok
test_full_pipeline_processes_ordered_dynamic_frames_with_cached_handoff (test_video_pipeline.VideoPipelineTests.test_full_pipeline_processes_ordered_dynamic_frames_with_cached_handoff) ... ok
test_full_pipeline_rejects_unknown_rgbx_handoff (test_video_pipeline.VideoPipelineTests.test_full_pipeline_rejects_unknown_rgbx_handoff) ... ok
test_full_pipeline_retains_selectable_zero_copy_handoff (test_video_pipeline.VideoPipelineTests.test_full_pipeline_retains_selectable_zero_copy_handoff) ... ok
test_full_pipeline_sends_fpga_mb420_without_arm_conversion (test_video_pipeline.VideoPipelineTests.test_full_pipeline_sends_fpga_mb420_without_arm_conversion) ... ok
test_mb420_dual_core_roles_and_network_irq_are_reported (test_video_pipeline.VideoPipelineTests.test_mb420_dual_core_roles_and_network_irq_are_reported) ... ok
test_network_irq_tuning_requires_cpu_affinity (test_video_pipeline.VideoPipelineTests.test_network_irq_tuning_requires_cpu_affinity) ... ok
test_overlap_executes_after_dma_launch_before_wait_and_recovers_on_error (test_video_pipeline.VideoPipelineTests.test_overlap_executes_after_dma_launch_before_wait_and_recovers_on_error) ... ok
test_yuv_conversion_reuses_destination_and_validates_geometry (test_video_pipeline.VideoPipelineTests.test_yuv_conversion_reuses_destination_and_validates_geometry) ... ok

----------------------------------------------------------------------
Ran 248 tests in 20.278s

OK (skipped=5)
