killua365/fpgachina2026-sr-lut/report/validation/reorganization_checks/reference_tests.txt

test_all_images_base_addresses (test_model_s_address.ModelSAddressTests.test_all_images_base_addresses) ... ok
test_known_coordinates_and_endpoints (test_model_s_address.ModelSAddressTests.test_known_coordinates_and_endpoints) ... ok
test_matches_numpy_flattening (test_model_s_address.ModelSAddressTests.test_matches_numpy_flattening) ... ok
test_parameters (test_model_s_address.ModelSAddressTests.test_parameters) ... ok
test_rejects_invalid_inputs (test_model_s_address.ModelSAddressTests.test_rejects_invalid_inputs) ... ok
test_vertex_mask_bit_order (test_model_s_address.ModelSAddressTests.test_vertex_mask_bit_order) ... ok
test_known_psnr_value (test_model_s_evaluation.ModelSEvaluationTests.test_known_psnr_value) ... ok
test_metrics_csv_and_averages (test_model_s_evaluation.ModelSEvaluationTests.test_metrics_csv_and_averages) ... ok
test_rgb_metrics_identical_and_colour_change (test_model_s_evaluation.ModelSEvaluationTests.test_rgb_metrics_identical_and_colour_change) ... ok
test_rgb_to_ycbcr_black_and_white (test_model_s_evaluation.ModelSEvaluationTests.test_rgb_to_ycbcr_black_and_white) ... ok
test_saved_output_raw_hashes (test_model_s_evaluation.ModelSEvaluationTests.test_saved_output_raw_hashes) ... ok
test_ssim_identical_and_changed (test_model_s_evaluation.ModelSEvaluationTests.test_ssim_identical_and_changed) ... ok
test_stage_b_report_exists (test_model_s_evaluation.ModelSEvaluationTests.test_stage_b_report_exists) ... ok
test_x4_4bit_matches_existing_outputs (test_model_s_evaluation.ModelSEvaluationTests.test_x4_4bit_matches_existing_outputs) ... ok
test_fixed_x4_5bit_fingerprint (test_model_s_fusion.ModelSFusionTests.test_fixed_x4_5bit_fingerprint) ... ok
test_fusion_does_not_divide_by_four (test_model_s_fusion.ModelSFusionTests.test_fusion_does_not_divide_by_four) ... ok
test_matches_original_rotation_method (test_model_s_fusion.ModelSFusionTests.test_matches_original_rotation_method) ... ok
test_rejects_invalid_inputs (test_model_s_fusion.ModelSFusionTests.test_rejects_invalid_inputs) ... ok
test_restore_known_subpixel_rotations (test_model_s_fusion.ModelSFusionTests.test_restore_known_subpixel_rotations) ... ok
test_round_divide_ties_to_even_signed (test_model_s_fusion.ModelSFusionTests.test_round_divide_ties_to_even_signed) ... ok
test_hls_core_numerators (test_model_s_hls_vectors.ModelSHLSVectorTests.test_hls_core_numerators) ... ok
test_hls_fixed_image_vector (test_model_s_hls_vectors.ModelSHLSVectorTests.test_hls_fixed_image_vector) ... ok
test_hls_header_integrity (test_model_s_hls_vectors.ModelSHLSVectorTests.test_hls_header_integrity) ... ok
test_hls_rgb_word_packing_order (test_model_s_hls_vectors.ModelSHLSVectorTests.test_hls_rgb_word_packing_order) ... ok
test_hls_rounding_and_clip (test_model_s_hls_vectors.ModelSHLSVectorTests.test_hls_rounding_and_clip) ... ok
test_all_copied_images (test_model_s_input.ModelSInputTests.test_all_copied_images) ... ok
test_rejects_non_rgb_array (test_model_s_input.ModelSInputTests.test_rejects_non_rgb_array) ... ok
test_rejects_too_small_image (test_model_s_input.ModelSInputTests.test_rejects_too_small_image) ... ok
test_rejects_wrong_dtype (test_model_s_input.ModelSInputTests.test_rejects_wrong_dtype) ... ok
test_synthetic_reflect_values (test_model_s_input.ModelSInputTests.test_synthetic_reflect_values) ... ok
test_fixed_x4_5bit_fingerprint (test_model_s_interpolator.ModelSInterpolatorTests.test_fixed_x4_5bit_fingerprint) ... ok
test_lut_integrity_shape_and_dtype (test_model_s_interpolator.ModelSInterpolatorTests.test_lut_integrity_shape_and_dtype) ... ok
test_real_image_native_shapes (test_model_s_interpolator.ModelSInterpolatorTests.test_real_image_native_shapes) ... ok
test_rejects_invalid_inputs (test_model_s_interpolator.ModelSInterpolatorTests.test_rejects_invalid_inputs) ... ok
test_vectorized_matches_scalar (test_model_s_interpolator.ModelSInterpolatorTests.test_vectorized_matches_scalar) ... ok
test_zero_remainder_reads_base_vertex (test_model_s_interpolator.ModelSInterpolatorTests.test_zero_remainder_reads_base_vertex) ... ok
test_known_center_directions (test_model_s_neighborhoods.ModelSNeighborhoodTests.test_known_center_directions) ... ok
test_matches_original_rotation_method (test_model_s_neighborhoods.ModelSNeighborhoodTests.test_matches_original_rotation_method) ... ok
test_reflect_at_top_left (test_model_s_neighborhoods.ModelSNeighborhoodTests.test_reflect_at_top_left) ... ok
test_shape_dtype_and_center (test_model_s_neighborhoods.ModelSNeighborhoodTests.test_shape_dtype_and_center) ... ok
test_all_five_x4_4bit_images_match (test_model_s_output.ModelSOutputTests.test_all_five_x4_4bit_images_match) ... ok
test_golden_integrity (test_model_s_output.ModelSOutputTests.test_golden_integrity) ... ok
test_other_supported_output_shapes (test_model_s_output.ModelSOutputTests.test_other_supported_output_shapes) ... ok
test_rejects_invalid_blocks (test_model_s_output.ModelSOutputTests.test_rejects_invalid_blocks) ... ok
test_saved_output_round_trip (test_model_s_output.ModelSOutputTests.test_saved_output_round_trip) ... ok
test_stitch_synthetic_mapping (test_model_s_output.ModelSOutputTests.test_stitch_synthetic_mapping) ... ok
test_all_images_round_trip (test_model_s_quantizer.ModelSQuantizerTests.test_all_images_round_trip) ... ok
test_exact_boundaries_4bit (test_model_s_quantizer.ModelSQuantizerTests.test_exact_boundaries_4bit) ... ok
test_exact_boundaries_5bit (test_model_s_quantizer.ModelSQuantizerTests.test_exact_boundaries_5bit) ... ok
test_matches_original_formulas_for_all_u8_values (test_model_s_quantizer.ModelSQuantizerTests.test_matches_original_formulas_for_all_u8_values) ... ok
test_parameters (test_model_s_quantizer.ModelSQuantizerTests.test_parameters) ... ok
test_rejects_invalid_inputs (test_model_s_quantizer.ModelSQuantizerTests.test_rejects_invalid_inputs) ... ok
test_all_24_original_strict_paths (test_model_s_simplex.ModelSSimplexTests.test_all_24_original_strict_paths) ... ok
test_exhaustive_4bit_source_fingerprint (test_model_s_simplex.ModelSSimplexTests.test_exhaustive_4bit_source_fingerprint) ... ok
test_exhaustive_5bit_source_fingerprint (test_model_s_simplex.ModelSSimplexTests.test_exhaustive_5bit_source_fingerprint) ... ok
test_original_tie_cases (test_model_s_simplex.ModelSSimplexTests.test_original_tie_cases) ... ok
test_real_image_integration (test_model_s_simplex.ModelSSimplexTests.test_real_image_integration) ... ok
test_rejects_invalid_inputs (test_model_s_simplex.ModelSSimplexTests.test_rejects_invalid_inputs) ... ok

----------------------------------------------------------------------
Ran 58 tests in 18.278s

OK
