killua365/fpgachina2026-sr-lut/report/validation/submission_20261023/summary.md

# 提交包检查（2026-10-23）

[summary.json](summary.json) 汇总本次实际执行结果：348 项测试通过，未访问板卡。原有功能文件中的 694 项逐文件核对一致，包含算法、LUT、黄金数据、环境、位流和部署载荷。

| 检查 | 记录 |
|---|---|
| 参考模型、黄金数据 | `reference/`、`golden/` |
| 控制器、启动器 | `controller/`、`launcher/` |
| LUT、Skill | `lut.json`、`skill.json` |
| VGA 主机逻辑与路径 | `vga_tests.txt`、`build/candidates/nexys_vga_26102101/path_validation.json` |
| 独立目录与离线环境 | `portability/`，含 DP/VGA 启动检查及两套 Python 环境导入 |

本次只调整交付结构、说明文档及 VGA 主机路径配置。硬件实现、显示性能与实屏验收沿用各自注明日期的原始证据。完整提交文件清单和最终校验结果见 `board/release/file_manifest.json` 与 `report/validation/verify_result.json`。
