killua365/fpgachina2026-sr-lut/data/golden/source_videos/video_validation/source_contact_sheet.png

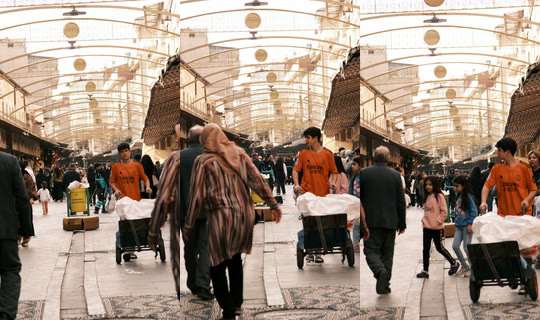
data/golden/source_videos/video_validation/source_contact_sheet.png
